FogCast-Konstanz/ceilometer/hardware/electronics/reference/schematic-sha256.txt

83A27CFF9CCC6BE23C81D1708697FAA548CE0A3112B7D12E5FBB0050944EA863  Ceilometer-Mainboard.kicad_sch
0DF4EA8A41C4C5A6A929BEEB0BAB2103AD3FB7023E3A1A09CEC28DEFCB5AE34C  laser_driver.kicad_sch
12897942866261051DC9896E344FCBBC590DF9CC13C2032FE289D9E452CD453B  microcontroller.kicad_sch
8D15DE4209DCBBF5A44544B6AAAC94CDBBDB7EB8A6270C29A0F63D7743F17740  power_supply.kicad_sch
557C2D40E5CBB65F0A0C12A197022C88FBC375FD6ED61630CAFE38675ACFBD1C  receiver.kicad_sch
54453B8D317E1929B59241BFBC5D7CDE180F8A41AEED6D8E985A71D2652C589C  TEC_driver.kicad_sch
