FogCast-Konstanz/ceilometer/docs/safety/Laser Safety calculation for 940 nm LIDAR.pdf

## Laser Safety calculation for 940 nm LIDAR

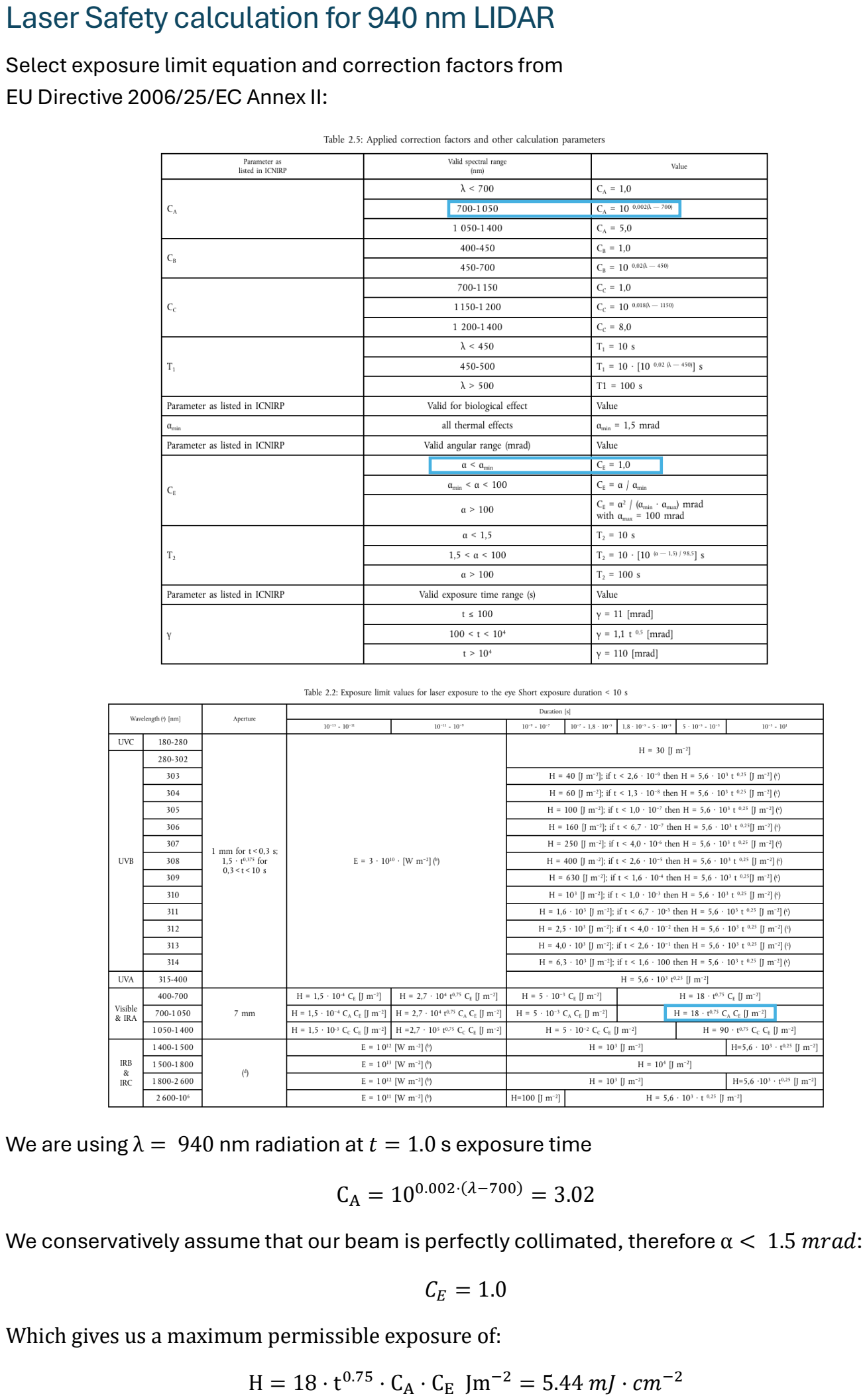
[picture p2: page 1]

Select exposure limit equation and correction factors from EU Directive 2006/25/EC Annex II:

We are using λ = 940 nm radiation at tt = 1.0 s exposure time

# CA = 100.002⋅(λλ−700) = 3.02

We conservatively assume that our beam is perfectly collimated, therefore α < 1.5 mmmmmmmm:

# CCEE = 1.0 Which gives us a maximum permissible exposure of: H = 18 ⋅ t0.75 ⋅ CA ⋅ CE Jm−2 = 5.44 mmmm · cc −2
