FogCast-Konstanz/ceilometer/hardware/mechanical/analysis/telescope/Mirror Cell Lever Load Study 1.html

Bildbreite (Pixel):

# Mirror Cell Lever Load Study

Analysierte Datei | Mirror Cell v4
Version | Autodesk Fusion (2605.1.52)
Erstellungsdatum | 2025-12-17, 17:04:57
Autor | Marian Keller

#### Berichtseigenschaften

Titel | Studien
Autor | Marian Keller

## Simulationsmodell 1

### Studie 1 - Nichtlineare statische Spannung

##### Eigenschaften der Studie

Studientyp | Nichtlineare statische Spannung
Letztes Änderungsdatum | 2025-12-17, 01:48:38

#### Einstellungen

##### Allgemein

Kontakttoleranz | 0.10 mm
Modi für starren Körper entfernen | Nein

##### Netz

Durchschnittl. Elementgröße (% der Modellgröße)
Volumenkörper | 10
Netzgröße pro Bauteil skalieren | Nein
Durchschnittliche Elementgröße (absoluter Wert) | -
Elementordnung | Parabolisch
Bogenförmige Netzelemente erstellen | Ja
Max. Drehwinkel auf Kurven (Grad) | 60
Max. Größenverhältnis benachbarter Netze | 1.5
Max. Seitenverhältnis | 10
Minimale Elementgröße (% der durchschnittlichen Größe) | 20

##### Verfeinerung adaptiver Netze

Anzahl der Verfeinerungsschritte | 0
Konvergenztoleranz für Ergebnisse (%) | 20

#### Materialien

Komponente | Material | Sicherheitsfaktor
Körper4 | Nylon 12 (mit 3D-Drucker Formlabs Fuse 1) | Streckgrenze

##### Nylon 12 (mit 3D-Drucker Formlabs Fuse 1)

Dichte | 1.015E-06 kg / mm^3
Elastizitätsmodul | 1850.00 MPa
Querdehnung | 0.35
Streckgrenze | 46.00 MPa
Zugfestigkeit | 50.00 MPa
Wärmeleitfähigkeit | 3.500E-04 W / (mm C)
Thermischer Ausdehnungskoeffizient | 1.275E-04 / C
Spezifische Wärme | 1830.00 J / (kg C)

#### Kontakte

#### Netz

Typ | Knoten | Elemente
Volumenkörper | 22067 | 12847

#### Lastfall1

#### Abhängigkeiten

##### Fest1

Typ | Fest
Ux | Fest
Uy | Fest
Uz | Fest

###### Ausgewählte Objekte

Verwenden Sie für die korrekte Interpretation dieses Bilds z. B. Internet Explorer 9, Chrome, Safari, Firefox.

#### Lasten

##### Kraft1

Typ | Kraft
Größe | 20.00 N
X-Wert | 0.00 N
Y-Wert | -20.00 N
Z-Wert | 0.00 N
Kraft pro Objekt | Nein

###### Ausgewählte Objekte

Verwenden Sie für die korrekte Interpretation dieses Bilds z. B. Internet Explorer 9, Chrome, Safari, Firefox.

#### Ergebnisse

##### Sicherheitsfaktor

##### Sicherheitsfaktor (pro Körper)

###### Schritt 10

0.00 8.00

Verwenden Sie für die korrekte Interpretation dieses Bilds z. B. Internet Explorer 9, Chrome, Safari, Firefox.

##### Spannung

##### von Mises

###### Schritt 10

[MPa] 0.00 4.689

Verwenden Sie für die korrekte Interpretation dieses Bilds z. B. Internet Explorer 9, Chrome, Safari, Firefox.

##### 1. Hauptspannung

###### Schritt 10

[MPa] -0.361 5.89

Verwenden Sie für die korrekte Interpretation dieses Bilds z. B. Internet Explorer 9, Chrome, Safari, Firefox.

##### 3. Hauptspannung

###### Schritt 10

[MPa] -3.531 0.989

Verwenden Sie für die korrekte Interpretation dieses Bilds z. B. Internet Explorer 9, Chrome, Safari, Firefox.

##### Verschiebung

##### Gesamt

###### Schritt 10

[mm] 0.00 0.235

Verwenden Sie für die korrekte Interpretation dieses Bilds z. B. Internet Explorer 9, Chrome, Safari, Firefox.

Bildbreite (Pixel):
