FogCast-Konstanz/ceilometer/hardware/electronics/mainboard/Ceilometer-Mainboard.csv

Reference | Qty | Value | DNP | Exclude from BOM | Exclude from Board | Footprint | MPN | Manufacturer
A1 | 1 | RaspberryPi Pico 2 |  |  |  | Module:RaspberryPi_Pico_Common_SMD | RP2350-Plus
C1,C2,C3,C13,C14,C15,C27,C28,C29,C30,C31,C55 | 12 | 47u |  |  |  | Capacitor_SMD:C_0805_2012Metric | LMK212BBJ476MG-T | Taiyo Yuden
C4,C5,C6,C9,C16,C21,C25,C26,C32,C33,C34,C35,C36,C37,C39,C40,C41,C42,C43,C44,C45,C46,C56,C57,C58,C60,C63,C66 | 28 | 1u |  |  |  | Capacitor_SMD:C_0402_1005Metric | C1005X5R1V105K050BE | TDK
C7,C8,C10,C11,C12,C17,C18,C22,C23,C24,C51,C54,C59,C64,C65 | 15 | 8.2n |  |  |  | Capacitor_SMD:C_0402_1005Metric | GRM1555C1H822JE01D | Murata
C19,C20,C38,C47,C48,C49,C50 | 7 | 220n |  |  |  | Capacitor_SMD:C_0402_1005Metric | GRM155R61J224ME01J | Murata
C52,C53 | 2 | 100p |  |  |  | Capacitor_SMD:C_0402_1005Metric | RF15N101J500CT | Walsin
C61,C62 | 2 | 100p |  |  |  | Capacitor_SMD:C_0201_0603Metric | CC0201JPNPO8BN101 | YAGEO
C67,C68 | 2 | 10u |  |  |  | Capacitor_SMD:C_0805_2012Metric |  | Murata
D1 | 1 | ESD321DYAR |  |  |  | Diode_SMD:D_SOD-523 | ESD321DYAR | TI
D2 | 1 | AFBR-S4P11P012R |  |  |  | SiPM_usr:Broadcom_AFBR-S4P11P012R | AFBR-S4P11P012R | Broadcom
F1 | 1 | 7A |  |  |  | Fuse:Fuseholder_Littelfuse_Nano2_154x | 0154007.DRT | Littlefuse
FB1,FB2 | 2 | 1.8k |  |  |  | Inductor_SMD:L_0402_1005Metric | MMZ1005A182ET000 | TDK
IC1 | 1 | LT8722AV#PBF |  |  |  | Analog_Devices_usr:LT8722AVPBF | LT8722AV#PBF | Analog Devices
J1 | 1 | 5V IN |  |  |  | TerminalBlock_RND:TerminalBlock_RND_205-00001_1x02_P5.00mm_Horizontal
J2 | 1 | TEC_OUT |  |  |  | Connector_Molex:Molex_Pico-EZmate_78171-0002_1x02-1MP_P1.20mm_Vertical
J3 | 1 | Conn_02x06_Odd_Even |  |  |  | Connector_PinHeader_2.54mm:PinHeader_2x06_P2.54mm_Vertical
J4,J5 | 2 | USB_C_Receptacle |  |  |  | Connector_USB:USB_C_Receptacle_Amphenol_12401610E4-2A | 12401610E4#2A | Amphenol
L1 | 1 | 22u |  |  |  | Inductor_SMD:L_Abracon_ASPI-4030S | ASPI-4030S-220M-T | Abracon
L2 | 1 | 1u |  |  |  | Inductor_SMD_Wurth:L_Wurth_WE-PMFI-252012 | 74479325207210 | Würth
L3 | 1 | 15u |  |  |  | Industor_usr:PFL4514 | PFL4514-153MEC | Coilcraft
LD1 | 1 | Laser Diode 940 nm |  |  |  | Connector_Molex:Molex_Pico-EZmate_78171-0002_1x02-1MP_P1.20mm_Vertical | 781710002 | Molex
R1 | 1 | 120 |  |  |  | Resistor_SMD:R_0402_1005Metric | ERA-2AEB121X | Panasonic
R2 | 1 | 200 |  |  |  | Resistor_SMD:R_0402_1005Metric | ERA-2AED201X | Panasonic
R3,R4,R5,R7,R11,R18,R19,R20,R33,R34,R35,R36 | 12 | 4k7 |  |  |  | Resistor_SMD:R_0402_1005Metric | ERA-2AED472X | Panasonic
R6,R13,R24,R25,R26,R27 | 6 | 1 |  |  |  | Resistor_SMD:R_0402_1005Metric | CRCW04021R00FKED | Vishay
R8,R10,R23,R28 | 4 | 10k |  |  |  | Resistor_SMD:R_0402_1005Metric | ERA-2AEB103X | Panasonic
R9 | 1 | 40m |  |  |  | Resistor_SMD:R_0603_1608Metric | PE0603DRF570R04L | YAGEO
R12 | 1 | 60.4 |  |  |  | Resistor_SMD:R_0402_1005Metric | RG1005P-60R4-D-T10 | Susumu
R14,R17 | 2 | 604k |  |  |  | Resistor_SMD:R_0402_1005Metric | CR0402-FX-6043GLF | Bourns
R15 | 1 | 4.99k |  |  |  | Resistor_SMD:R_0402_1005Metric | RT0402BRD074K99L | YAGEO
R16 | 1 | 33.2k |  |  |  | Resistor_SMD:R_0402_1005Metric | RT0402BRD0733K2L | YAGEO
R21 | 1 | 20k |  |  |  | Resistor_SMD:R_0402_1005Metric | ERA-2AED203X | Panasonic
R22 | 1 | 15.4k |  |  |  | Resistor_SMD:R_0402_1005Metric | RT0402BRD0715K4L | YAGEO
R29,R30 | 2 | 50 |  |  |  | Resistor_SMD:R_0402_1005Metric | TNPW040250R0BEED | Vishay
R31,R32 | 2 | 50 |  |  |  | Resistor_SMD:R_0201_0603Metric | TNPW020150R0DEED | Vishay
U1 | 1 | AZ1084 |  |  |  | Package_TO_SOT_SMD:TO-263-2 | AZ1084CD-ADJTRG1 | Diodes
U2,U6,U16 | 3 | AD5693R |  |  |  | Package_SO:MSOP-10_3x3mm_P0.5mm | AD5693RARMZ-RL7 | Analog Devices
U3 | 1 | iC-HG30 |  |  |  | Driver_Laser:QFN-28-1EP_5x5mm_P0.5mm_EP3.1x3.15mm_ThermalVias | iC-HG30 | ic-haus
U4 | 1 | INA293B1 |  |  |  | Package_TO_SOT_SMD:SOT-23-5 | INA293B1IDBVR | TI
U5 | 1 | LT3571 |  |  |  | LT3571:QFN-16-1EP_3x3mm_P0.5mm_EP1.45x1.45mm_ThermalVias | LT3571EUD#PBF | Analog Devices
U7,U9,U12 | 3 | NCV8161AMX330 |  |  |  | Package_SON_usr:Texas_XDFN-4_1x1mm_P0.65mm | NCV8161AMX330TBG | onsemi
U8 | 1 | TVS0500DRV |  |  |  | Package_SON:WSON-6-1EP_2x2mm_P0.65mm_EP1x1.6mm | TVS0500DRV | Texas Instruments
U10 | 1 | SN65LVDT2DBV |  |  |  | Package_TO_SOT_SMD:SOT-23-5 | SN65LVDT2DBV | TI
U11 | 1 | REF3030 |  |  |  | Package_TO_SOT_SMD:SOT-23 | REF3030AIDBZT | TI
U13 | 1 | NCV8161AMX180 |  |  |  | Package_SON_usr:Texas_XDFN-4_1x1mm_P0.65mm | NCV8161AMX330TBG | onsemi
U14 | 1 | QPL7442 |  |  |  | Package_DFN_QFN:DFN-8-1EP_2x2mm_P0.5mm_EP0.8x1.6mm | QPL7442 | Qorvo
U15 | 1 | TLV3801 |  |  |  | Comparator_usr:TLV3801DSGR | TLV3801DSGR | Texas Instruments
U17 | 1 | MCP9800A |  |  |  | Package_TO_SOT_SMD:SOT-23-5 | MCP9800A0T-M/OT | Microchip
U18 | 1 | DS18B20 |  |  |  | Connector_PinHeader_2.54mm:PinHeader_1x03_P2.54mm_Vertical | DS18B20 | Analog Devices
