FogCast-Konstanz/ceilometer/hardware/electronics/mainboard/Ceilometer-Mainboard-B2-Edge_Cuts.dxf

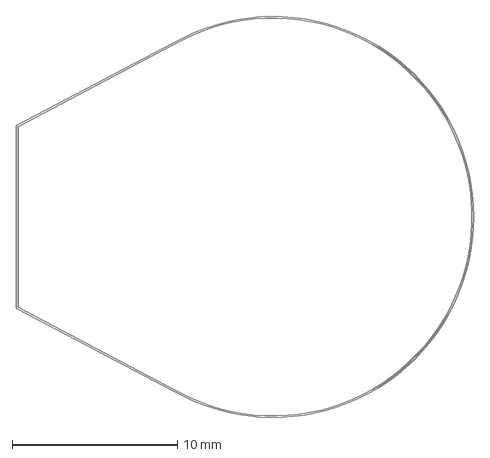
[picture p3: CAD file, 2026-11-01]
hardware/electronics/mainboard/Ceilometer-Mainboard-B2-Edge_Cuts.dxf
27.7 x 24.3 mm
