FogCast-Konstanz/ceilometer/hardware/electronics/mainboard/3D/ti/TLV3801DSGR.stp

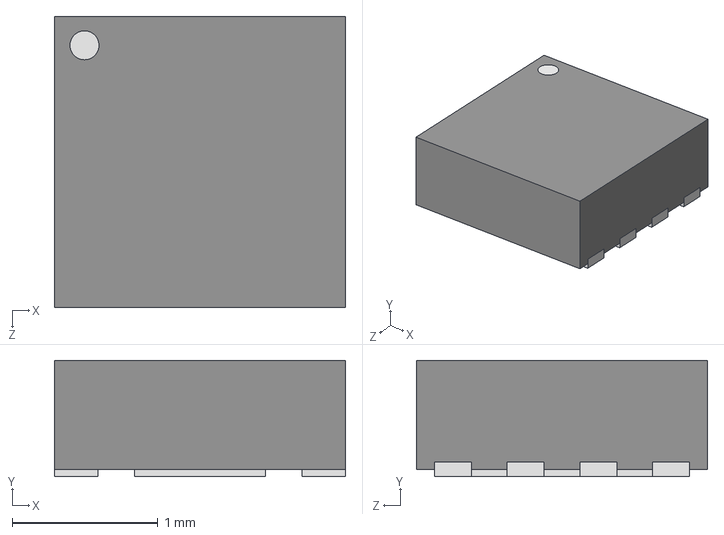
[picture p4: CAD file, 2026-11-01]
hardware/electronics/mainboard/3D/ti/TLV3801DSGR.stp
2.00 x 0.8 x 2.00 mm
