FogCast-Konstanz/ceilometer/hardware/mechanical/cad/exchange/Ceilometer-Optikplatte.dxf

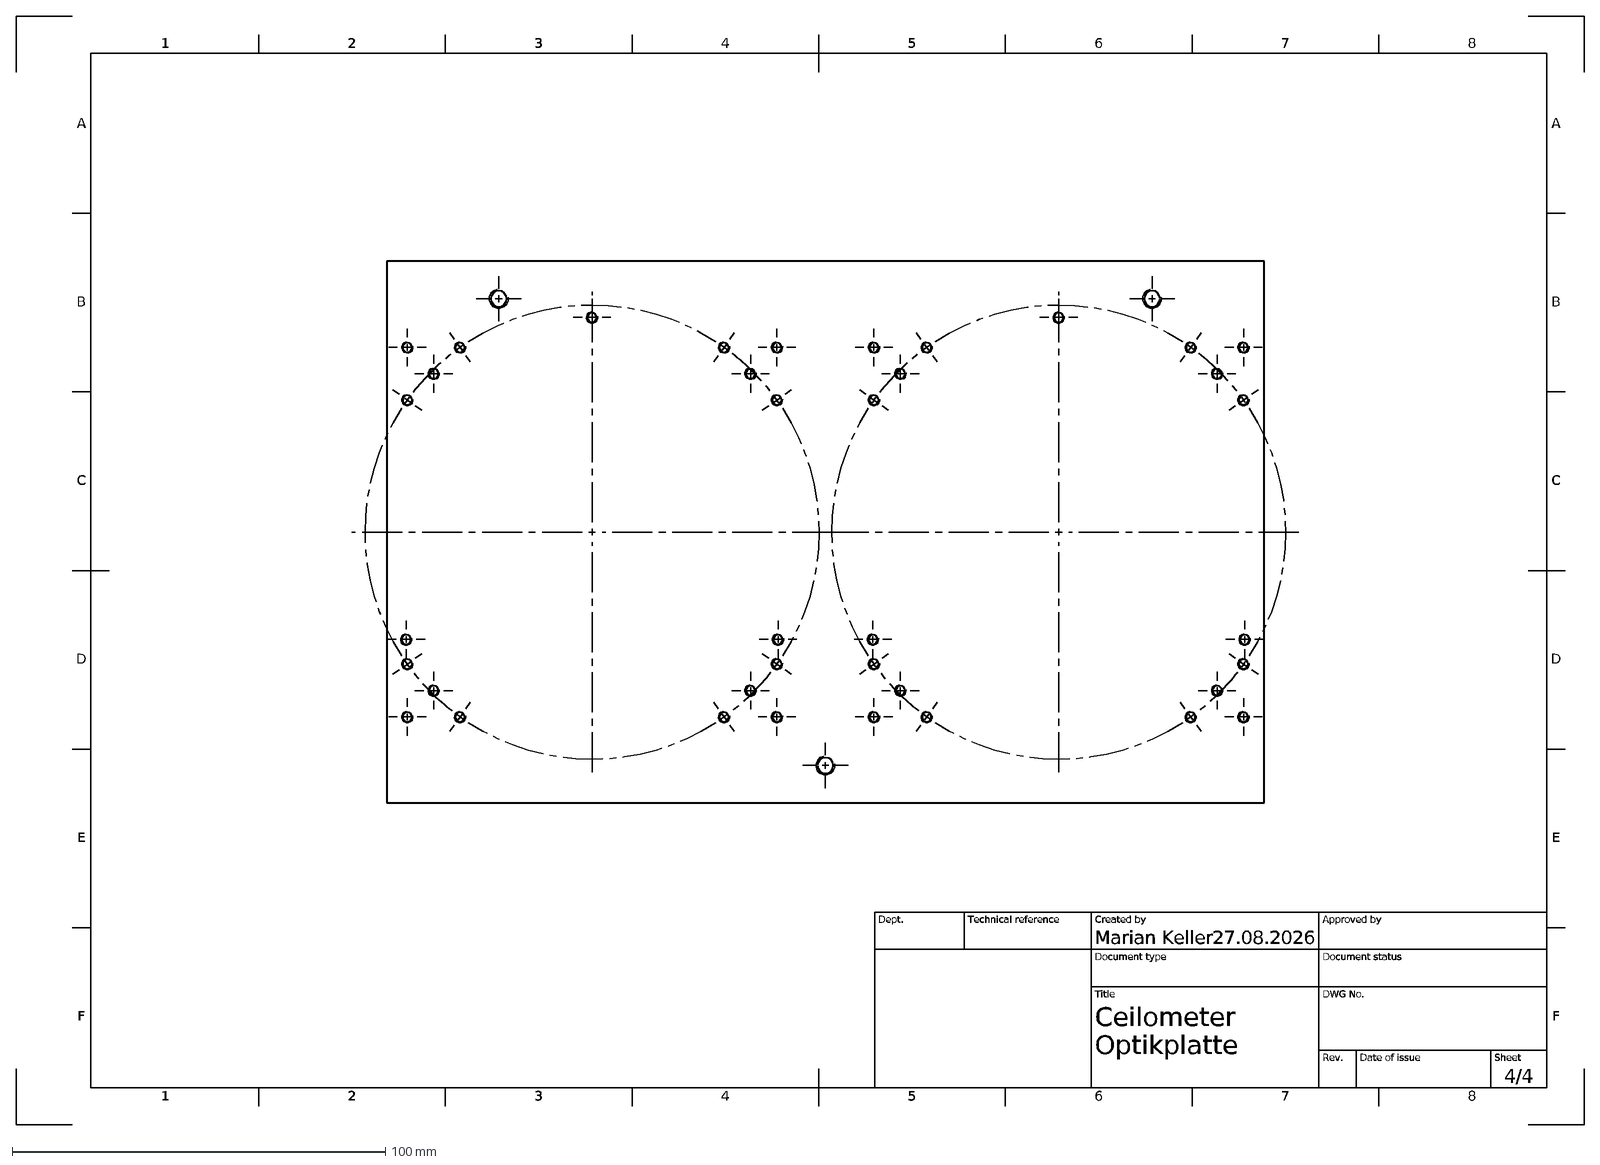
[picture p5: CAD file, 2026-11-01]
hardware/mechanical/cad/exchange/Ceilometer-Optikplatte.dxf
27.08.2026
4/4
Optikplatte
Ceilometer
Marian Keller
Dept.
Technical reference
Created by
Approved by
Document type
Document status
Title
DWG No.
Rev.
Date of issue
Sheet
1
A
2
3
4
5
6
7
8
B
C
D
E
F
