FogCast-Konstanz/ceilometer/(list of files, cad)

Other CAD files:
hardware/electronics/mainboard/Ceilometer-Mainboard-B.step
hardware/mechanical/cad/exchange/Ceilometer-Rahmen v9.step
hardware/mechanical/cad/meshes/Laser-Clamp.stl
hardware/mechanical/printing/Strebenhalter.3mf
hardware/mechanical/cad/meshes/Strebenhalter.stl
hardware/mechanical/printing/Spiegelhalteblock.3mf
hardware/mechanical/cad/meshes/Rohrzentrierer.stl
hardware/mechanical/printing/Endhalter_plate_2.gcode.3mf
hardware/mechanical/cad/meshes/Transmitter-Mount.stl
hardware/mechanical/printing/Strebenhalter.gcode.3mf
hardware/mechanical/cad/meshes/Receiver-Mount.stl
hardware/mechanical/printing/Endhalter.gcode.3mf
hardware/mechanical/cad/meshes/Spiegelhalteblock.stl
hardware/mechanical/printing/Endhalter.3mf
hardware/mechanical/cad/meshes/Endhalter.stl
hardware/mechanical/cad/meshes/Spannring.stl
