FogCast-Konstanz/ceilometer/docs/mainboard-overclock-results.txt

$ACK,get_clock,500000000,500000,18
$ACK,i2c_scan,0,1,1,1,1,0,110,2,76,78
$ACK,i2c_scan,1,1,1,1,1,0,110,2,72,78
$ACK,get_telemetry,dac0_readback,code,0,1,24835171,50019,249
$ACK,get_telemetry,dac1_readback,code,0,1,24835474,50358,249
$ACK,get_telemetry,dac2_readback,code,0,1,24835777,50843,249
$ACK,get_telemetry,lt_register0,bits,565780,1,24835853,51450,249
$ACK,get_clock,500000000,500000,18
$ACK,sensors,64,697,0,1,23125,1,45312
$ACK,get_telemetry,mcu_temperature_mc,mC,61865,1,24832344,63314,249
$ACK,get_telemetry,lt_register0,bits,565780,1,24835853,60466,249
$ACK,get_state,IDLE,0,0,0,0,0,0,0
$ACK,get_clock,500000000,500000,18
$ACK,sensors,66,694,0,1,23125,1,45312
$ACK,get_telemetry,mcu_temperature_mc,mC,61865,1,25332345,70284,254
$ACK,get_telemetry,lt_register0,bits,565780,1,25335854,67271,254
$ACK,get_state,IDLE,0,0,0,0,0,0,0
$ACK,get_clock,500000000,500000,18
$ACK,sensors,67,688,0,1,23125,1,45250
$ACK,get_telemetry,mcu_temperature_mc,mC,61865,1,25832345,82222,259
$ACK,get_telemetry,lt_register0,bits,565780,1,25835854,79400,259
$ACK,get_state,IDLE,0,0,0,0,0,0,0
$ACK,get_clock,500000000,500000,18
$ACK,sensors,66,688,0,1,23125,1,45312
$ACK,get_telemetry,mcu_temperature_mc,mC,61865,1,26332345,90967,264
$ACK,get_telemetry,lt_register0,bits,565780,1,26335854,88124,264
$ACK,get_state,IDLE,0,0,0,0,0,0,0
$ACK,get_clock,500000000,500000,18
$ACK,sensors,64,685,0,1,23125,1,45312
$ACK,get_telemetry,mcu_temperature_mc,mC,61865,1,26932346,4101,270
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
$ACK,get_state,IDLE,0,0,0,0,0,0,0
$ACK,get_clock,500000000,500000,18
$ACK,sensors,66,692,0,1,23187,1,46750
$ACK,get_telemetry,mcu_temperature_mc,mC,62717,1,70332503,55850,704
$ACK,get_telemetry,lt_register0,bits,565780,1,70336013,52953,704
$ACK,get_state,IDLE,0,0,0,0,0,0,0
