FogCast-Konstanz/ceilometer/software/bringup/index.html

⌁

# Ceilometer board console

DisconnectedTry demoConnect USBDisconnect■ Stop all

SIMULATED BOARD · No hardware connection Inject fault

Web Serial is unavailable. Open this page in desktop Chrome or Edge. Demo mode remains available.

Connect the Pico 2 USB port to inspect the board, or explore demo mode.

No board connectedOFFLINEOutputs —Storage —

Laser temperature—

Receiver temperature—

TEC differential output—

SiPM count rate—

SiPM bias target—

## Transmitter

### TEC regulation

OFF

Waiting for temperature feedback

Enable PIDDisable TEC

Set target, PID gains and commissioned polarity in Parameters.

### Laser driver

DISARMED

Arm laserDisarm / stop outputs

Laser DAC code ceiling —Apply laser DAC

Firmware enforces the temperature window, fault latch and build ceiling.

## Receiver

### SiPM bias

OFF

Waiting for receiver feedback

Enable biasDisable bias

Test temperature (°C) Enable bias without receiver (test)

### Discriminator

Counter (16-bit, wraps)—

Receiver threshold / mV

Apply threshold

Save in Parameters to persist

## Board diagnostics

Read feedback first, then exercise each functional block.

GP12 test pulse / Hz

Apply pulsePulse off

Scan receiver I²CScan main I²C

I²C scan requires all outputs off

Clear faultRefresh inventory

Loopback requires a verified GP12 → GP5 bench connection. Clearing a fault never restarts outputs.

LIVE INSTRUMENTATION

## Temperature traces

Pause plotClear

10−1

°C

−30 snow

Connect to begin polling
Invalid feedback leaves gaps in the trace

Export telemetry CSV

Plot channel Add traceUp to 4 channels with matching units

05

## Digital acquisition

1023 BINS

Dark capture keeps the laser gate low and emits diagnostic PRN on GP13.

FramesDark captureEmitting captureRead board resultExport capture CSV

Start repeated darkStart repeated laserRead integrated result

## Peripheral health

Not polling

## All board telemetry

Values are exact firmware integers. Age includes time since the browser received the sample. The table marks stale links and failed device reads.

Signal | Value | Unit | Validity | Age / ms | Sequence | Trace

## Persistent configuration

Export JSON

Stage up to eight changes and apply them atomically. All outputs and acquisition must be off. Save explicitly to persist; enable/arm states are never stored.

Apply staged 0Save to flashLoad savedRAM defaultsDiscard edits

Parameter | Current | Staged value | Unit | Bounds | Default

## USB command log

Export logClear log

CommandSend

Exact ASCII protocol, one request at a time. Sending configuration or output commands here still uses firmware interlocks. A timeout closes the session to avoid accepting a late ACK.
