FogCast-Konstanz/ceilometer/docs/production-overclock-results.txt

$ACK,stop
$ACK,get_clock,500000000,500000,18
$ACK,get_param,bias_gain_ppm,989241,ppm_of_nominal,800000,1200000,1000000
$ACK,get_param,bias_offset_uv,-4925156,uV,-6000000,-4000000,-5000000
$ACK,capture
$ACK,get_state,READY,16,0,1638,0,0,0,44009
$ACK,capture
$ACK,get_state,READY,16,0,1637,0,0,0,44009
$ACK,capture
$ACK,get_state,READY,16,0,1638,0,0,0,44008
$ACK,capture
$ACK,get_state,READY,16,0,1638,0,0,0,44009
$ACK,capture
$ACK,get_state,READY,16,0,1638,0,0,0,44009
$ACK,capture
$ACK,get_state,READY,16,0,1638,0,0,0,44009
$ACK,capture
$ACK,get_state,READY,16,0,1638,0,0,0,44009
$ACK,capture
$ACK,get_state,READY,16,0,1638,0,0,0,44008
$ACK,capture
$ACK,get_state,READY,16,0,1637,0,0,0,44009
$ACK,capture
$ACK,get_state,READY,16,0,1637,0,0,0,44009
$ACK,capture
$ACK,get_state,READY,16,0,1638,0,0,0,44008
$ACK,capture
$ACK,get_state,READY,16,0,1637,0,0,0,44009
$ACK,capture
$ACK,get_state,READY,16,0,1637,0,0,0,44009
$ACK,capture
$ACK,get_state,READY,16,0,1638,0,0,0,44008
$ACK,capture
$ACK,get_state,READY,16,0,1638,0,0,0,44008
$ACK,capture
$ACK,get_state,READY,16,0,1638,0,0,0,44008
$ACK,capture
$ACK,get_state,READY,16,0,1637,0,0,0,44009
$ACK,capture
$ACK,get_state,READY,16,0,1638,0,0,0,44009
$ACK,capture
$ACK,get_state,READY,16,0,1638,0,0,0,44008
$ACK,capture
$ACK,get_state,READY,16,0,1638,0,0,0,44009
$ACK,sensors,63,673,0,1,23375,1,52937
$ACK,get_storage,1,0,23,22,0,2
$ACK,stop
