FogCast-Konstanz/ceilometer/analysis/bench-tests/legacy/bias-off-idle-repeat.csv

threshold_mv | threshold_code | counts | duration_us | rate_cps | max_poll_gap_us | prn_enabled | bias_enabled
1795 | 47055 | 0 | 1000000 | 0.000 | 2 | 0 | 0
1800 | 47186 | 0 | 1000000 | 0.000 | 2 | 0 | 0
1804 | 47291 | 0 | 1000000 | 0.000 | 2 | 0 | 0
1805 | 47317 | 0 | 1000000 | 0.000 | 2 | 0 | 0
1806 | 47343 | 0 | 1000000 | 0.000 | 2 | 0 | 0
1806.5 | 47356 | 1289 | 1000000 | 1289.000 | 2 | 0 | 0
1807 | 47369 | 2684900 | 1000000 | 2684900.000 | 2 | 0 | 0
1807.5 | 47383 | 56973227 | 1000000 | 56973227.000 | 2 | 0 | 0
1808 | 47396 | 29732271 | 1000000 | 29732271.000 | 2 | 0 | 0
1808.5 | 47409 | 1004793 | 1000000 | 1004793.000 | 2 | 0 | 0
1809 | 47422 | 2010 | 1000000 | 2010.000 | 2 | 0 | 0
1810 | 47448 | 0 | 1000000 | 0.000 | 2 | 0 | 0
1815 | 47579 | 0 | 1000000 | 0.000 | 2 | 0 | 0
