FogCast-Konstanz/ceilometer/analysis/bench-tests/legacy/bias-series-1809p4.csv

mode | ov_mv | threshold_code | threshold_mv | counts | duration_us | rate_cps | first_second_counts | second_second_counts | max_poll_gap_us | temperature_start_mc | temperature_end_mc | target_start_uv | target_end_uv | estimated_end_uv | bias_code
off_before | 0 | 47432 | 1809.4 | 0 | 2000000 | 0.000 | 0 | 0 | 2 | 57000 | 56937 | 48740000 | 48735590 | 48734933 | 58824
on | 1000 | 47432 | 1809.4 | 0 | 2000000 | 0.000 | 0 | 0 | 2 | 56937 | 56937 | 39735590 | 39735590 | 39735027 | 48958
on | 2000 | 47432 | 1809.4 | 1 | 2000000 | 0.500 | 0 | 1 | 2 | 56937 | 57000 | 40735590 | 40740000 | 40739375 | 50059
on | 3000 | 47432 | 1809.4 | 0 | 2000000 | 0.000 | 0 | 0 | 2 | 57000 | 56937 | 41740000 | 41735590 | 41735513 | 51151
on | 4000 | 47432 | 1809.4 | 9 | 2000000 | 4.500 | 6 | 3 | 2 | 56937 | 56937 | 42735590 | 42735590 | 42735300 | 52247
on | 5000 | 47432 | 1809.4 | 88 | 2000000 | 44.000 | 37 | 51 | 2 | 56937 | 56937 | 43735590 | 43735590 | 43735087 | 53343
on | 6000 | 47432 | 1809.4 | 951 | 2000000 | 475.500 | 427 | 524 | 2 | 56937 | 56937 | 44735590 | 44735590 | 44734873 | 54439
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
