FogCast-Konstanz/ceilometer/analysis/bench-tests/legacy/dark-overvoltage-sweep.csv

ov_mv | threshold_mv | threshold_code | counts | integration_us | rate_cps | temperature_mc | target_uv | estimated_uv | bias_code
5000 | 1798 | 47133 | 0 | 16368 | 0.000 | 55625 | 43643750 | 43642953 | 53242
5000 | 1800 | 47186 | 0 | 16368 | 0.000 | 55625 | 43643750 | 43642953 | 53242
5000 | 1801 | 47212 | 0 | 16368 | 0.000 | 55625 | 43643750 | 43642953 | 53242
5000 | 1802 | 47238 | 0 | 16368 | 0.000 | 55625 | 43643750 | 43642953 | 53242
5000 | 1803 | 47265 | 0 | 16368 | 0.000 | 55625 | 43643750 | 43642953 | 53242
5000 | 1804 | 47291 | 10 | 16368 | 610.948 | 55625 | 43643750 | 43642953 | 53242
5000 | 1805 | 47317 | 1305 | 16368 | 79728.739 | 55625 | 43643750 | 43642953 | 53242
5000 | 1806 | 47343 | 38663 | 16368 | 2362108.993 | 55625 | 43643750 | 43642953 | 53242
5000 | 1807 | 47369 | 452088 | 16368 | 27620234.604 | 55625 | 43643750 | 43642953 | 53242
5000 | 1808 | 47396 | 576864 | 16368 | 35243401.760 | 55625 | 43643750 | 43642953 | 53242
5000 | 1809 | 47422 | 45 | 16368 | 2749.267 | 55625 | 43643750 | 43642953 | 53242
5000 | 1810 | 47448 | 0 | 16368 | 0.000 | 55625 | 43643750 | 43642953 | 53242
5000 | 1812 | 47500 | 0 | 16368 | 0.000 | 55687 | 43648090 | 43647514 | 53247
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
