FogCast-Konstanz/ceilometer/analysis/bench-tests/legacy/high-threshold-dark-sweep.csv

bias_enabled | threshold_mv | threshold_code | counts | duration_us | rate_cps | max_poll_gap_us | temperature_mc | target_uv
0 | 1809.1 | 47424 | 255 | 1000000 | 255.000 | 2 | 56812 | 48726840
0 | 1809.2 | 47427 | 126 | 1000000 | 126.000 | 2 | 56812 | 48726840
0 | 1809.4 | 47432 | 0 | 1000000 | 0.000 | 2 | 56750 | 48722500
0 | 1809.6 | 47438 | 0 | 1000000 | 0.000 | 2 | 56812 | 48726840
0 | 1809.8 | 47443 | 0 | 1000000 | 0.000 | 2 | 56812 | 48726840
0 | 1810 | 47448 | 0 | 1000000 | 0.000 | 2 | 56812 | 48726840
0 | 1810.2 | 47453 | 0 | 1000000 | 0.000 | 2 | 56812 | 48726840
0 | 1810.5 | 47461 | 0 | 1000000 | 0.000 | 2 | 56812 | 48726840
0 | 1811 | 47474 | 0 | 1000000 | 0.000 | 2 | 56875 | 48731250
0 | 1812 | 47500 | 0 | 1000000 | 0.000 | 2 | 56812 | 48726840
0 | 1815 | 47579 | 0 | 1000000 | 0.000 | 2 | 56812 | 48726840
0 | 1820 | 47710 | 0 | 1000000 | 0.000 | 2 | 56812 | 48726840
0 | 1850 | 48497 | 0 | 1000000 | 0.000 | 2 | 56812 | 48726840
1 | 1809.1 | 47424 | 986660 | 1000000 | 986660.000 | 2 | 56812 | 48726840
1 | 1809.2 | 47427 | 544339 | 1000000 | 544339.000 | 2 | 56750 | 48722500
1 | 1809.4 | 47432 | 222364 | 1000000 | 222364.000 | 2 | 56750 | 48722500
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
