FogCast-Konstanz/ceilometer/hardware/mechanical/analysis/mockup/Mockup Zeichnung v0.pdf

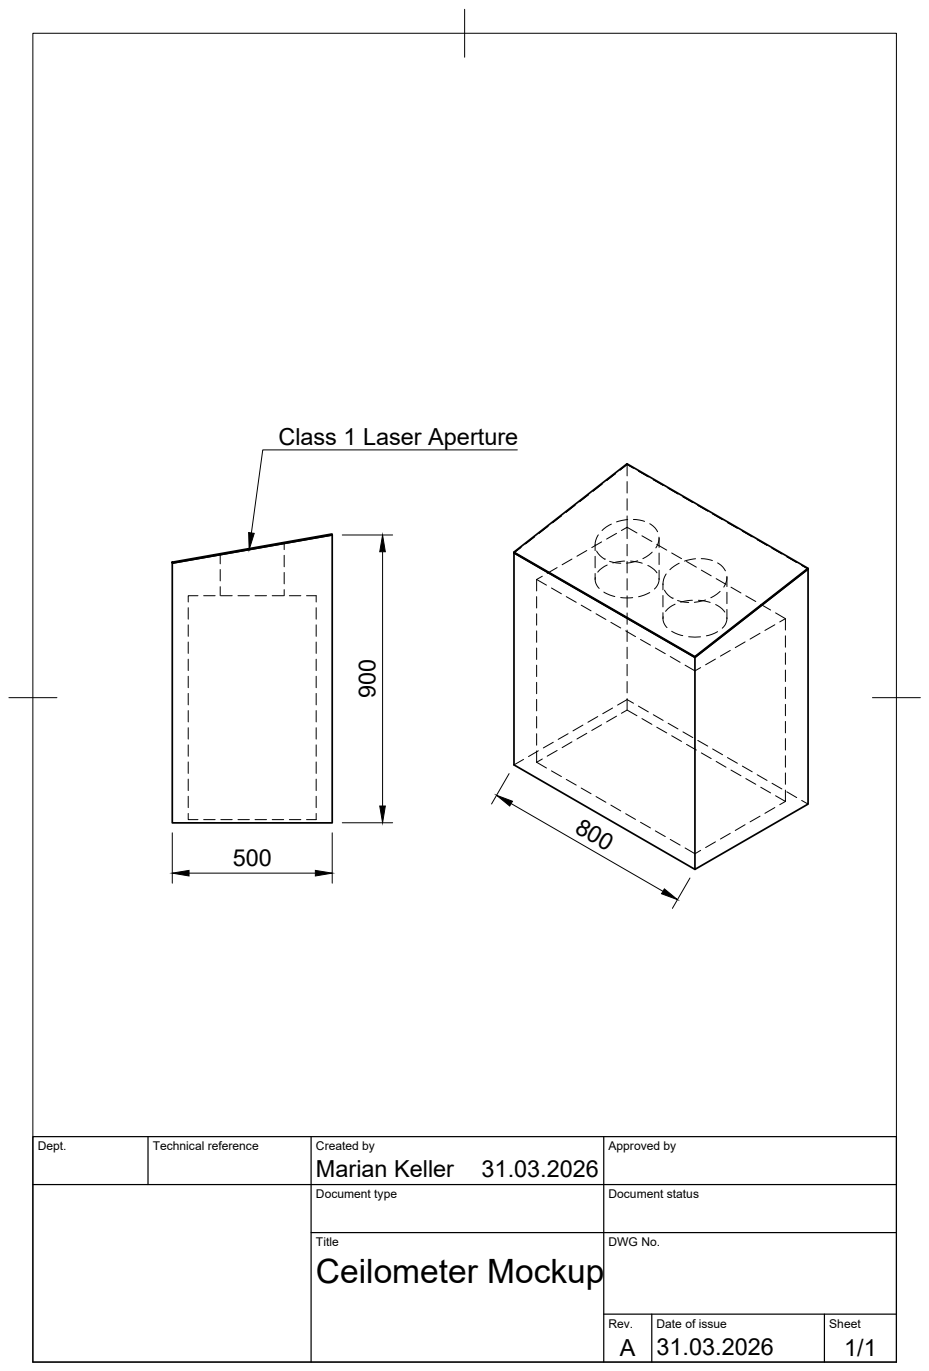
[picture p6: page 1]

Class 1 Laser Aperture
Marian Keller 900

Dept. | Technical reference | Created by 31.03.2026 | Approved by

Document type | Document status

Title Ceilometer Mockup | DWG No.

Rev. A | Date of issue 31.03.2026 | Sheet 1/1
