FogCast-Konstanz/ceilometer/hardware/electronics/simulations/LD_CS_Filter_Bode.pdf

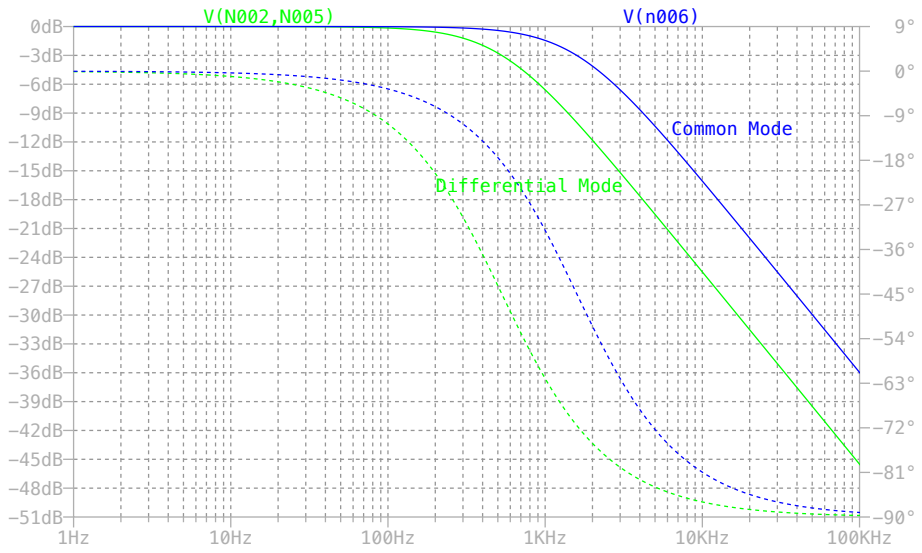
[picture p7: page 1]
