FogCast-Konstanz/ceilometer/hardware/electronics/simulations/LD_CS_Filter_Ripple.pdf

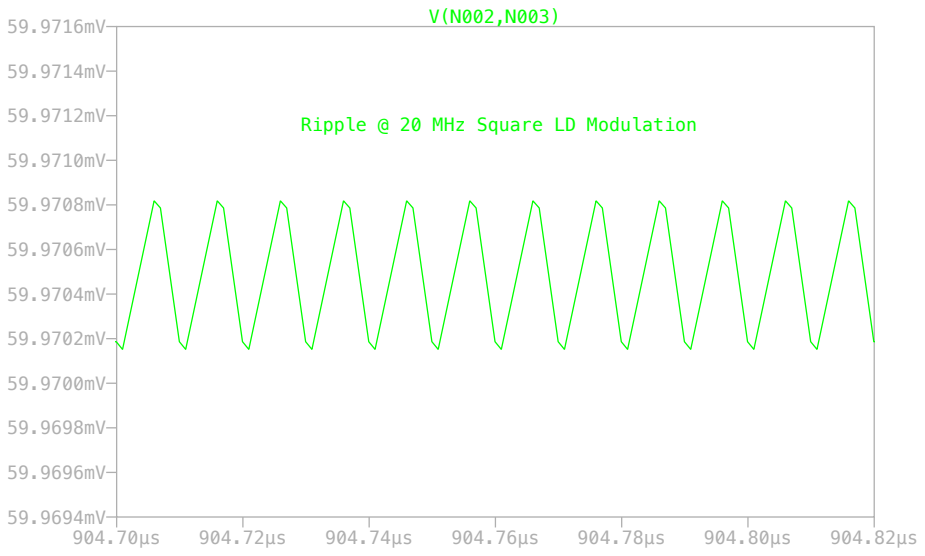
[picture p8: page 1]

Ripple @ 20 MHz Square LD Modulation
