FogCast-Konstanz/ceilometer/hardware/mechanical/drawings/Ceilometer-Rahmen Zeichnung v3.pdf

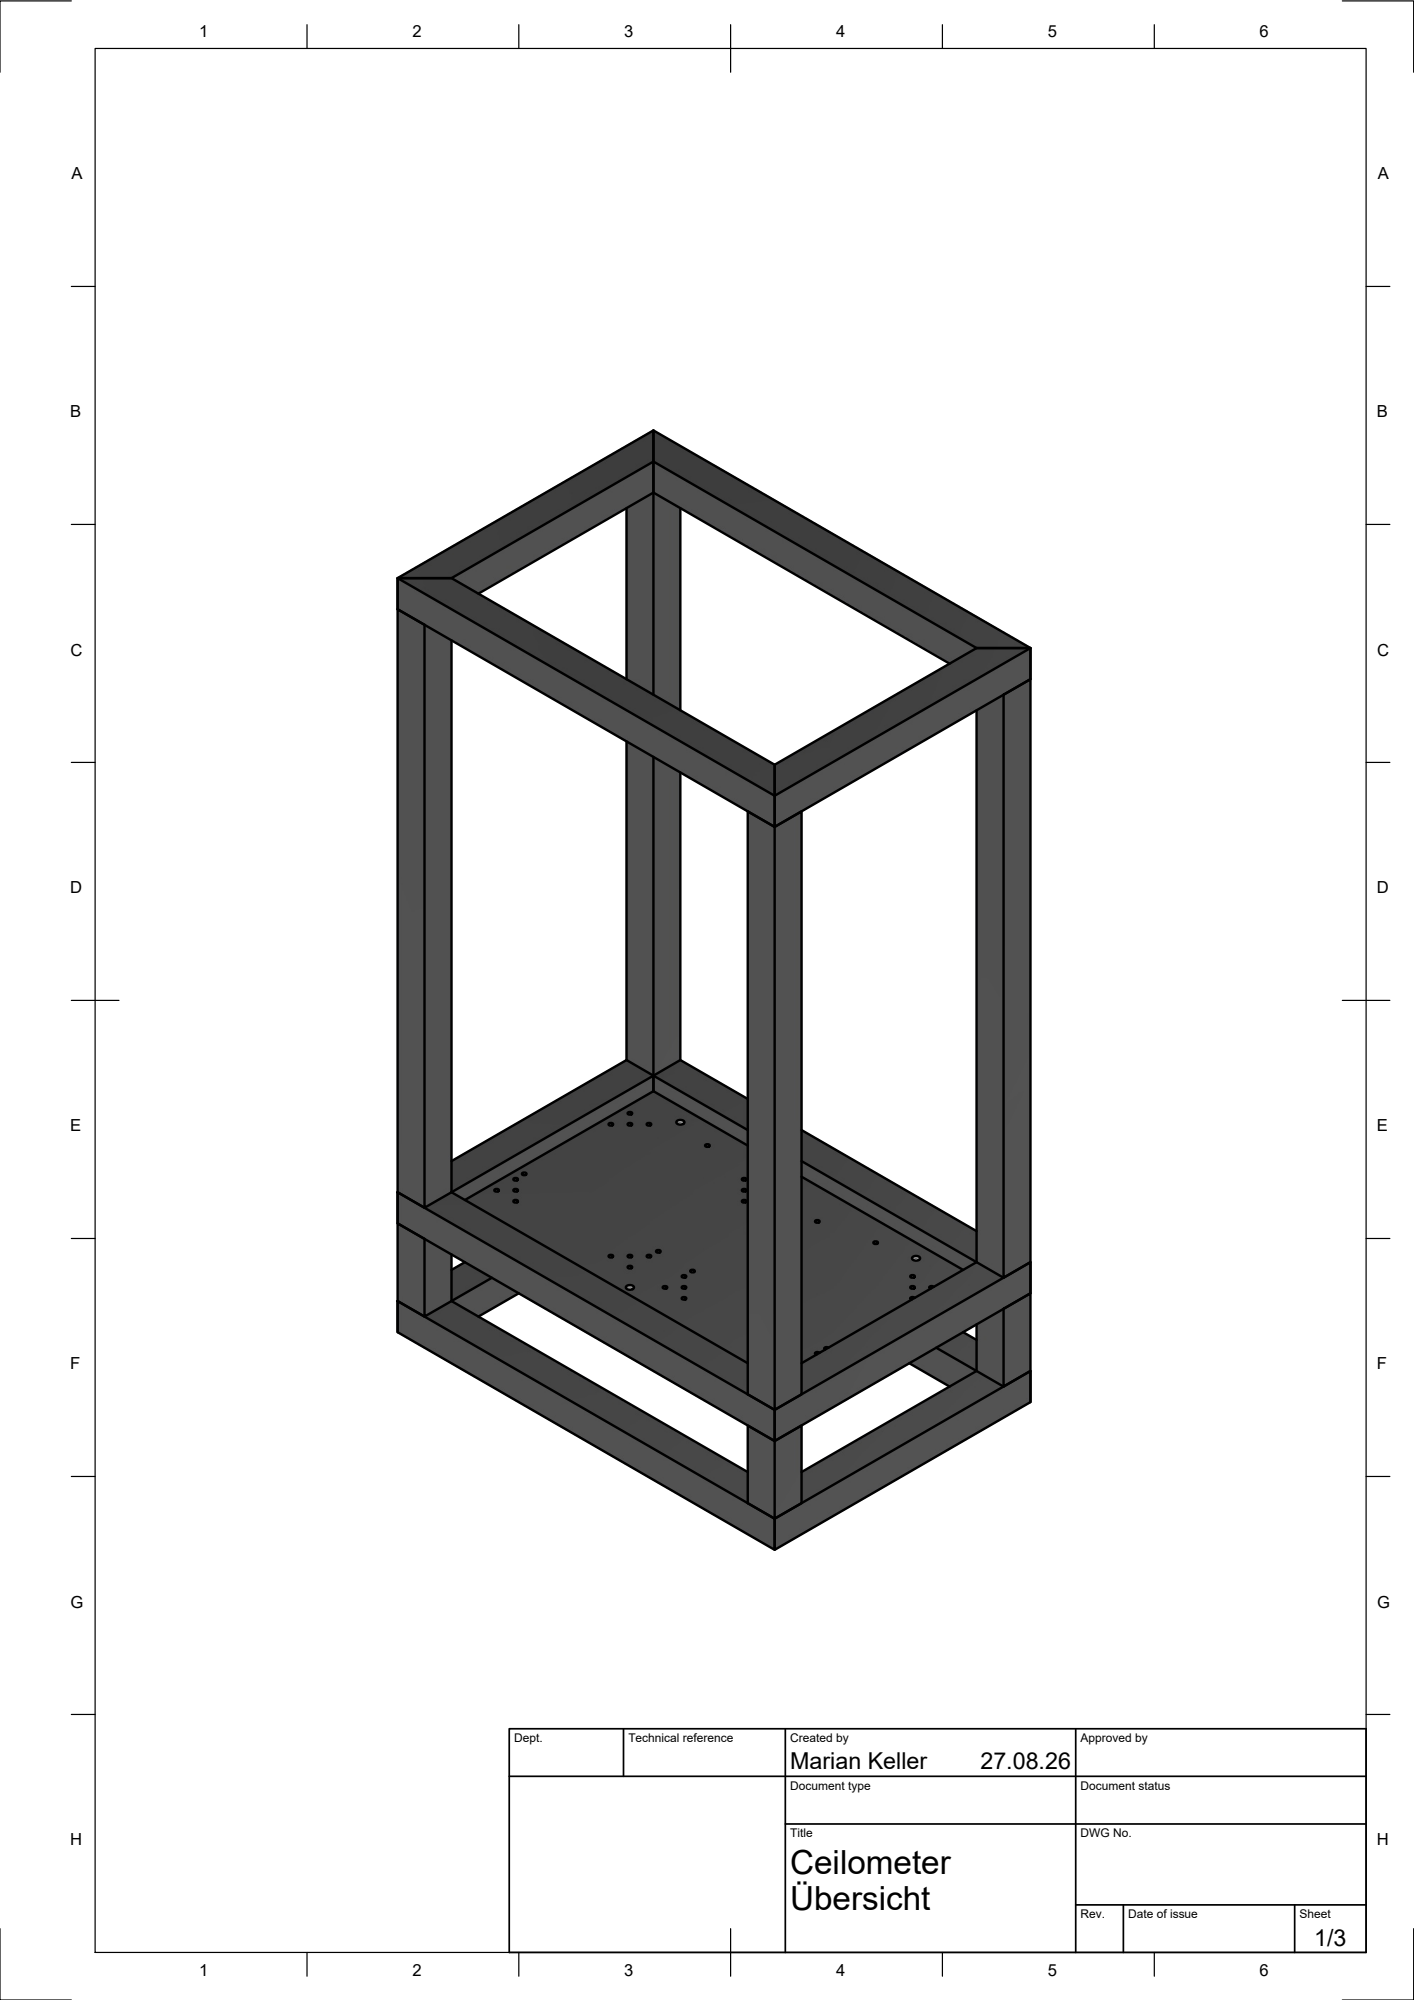
[picture p9: page 1]

Dept. | Technical reference | Created by Marian Keller 27.08.26 | Approved by

Document type | Document status

Title Ceilometer Übersicht | DWG No.

Rev. | Date of issue | Sheet

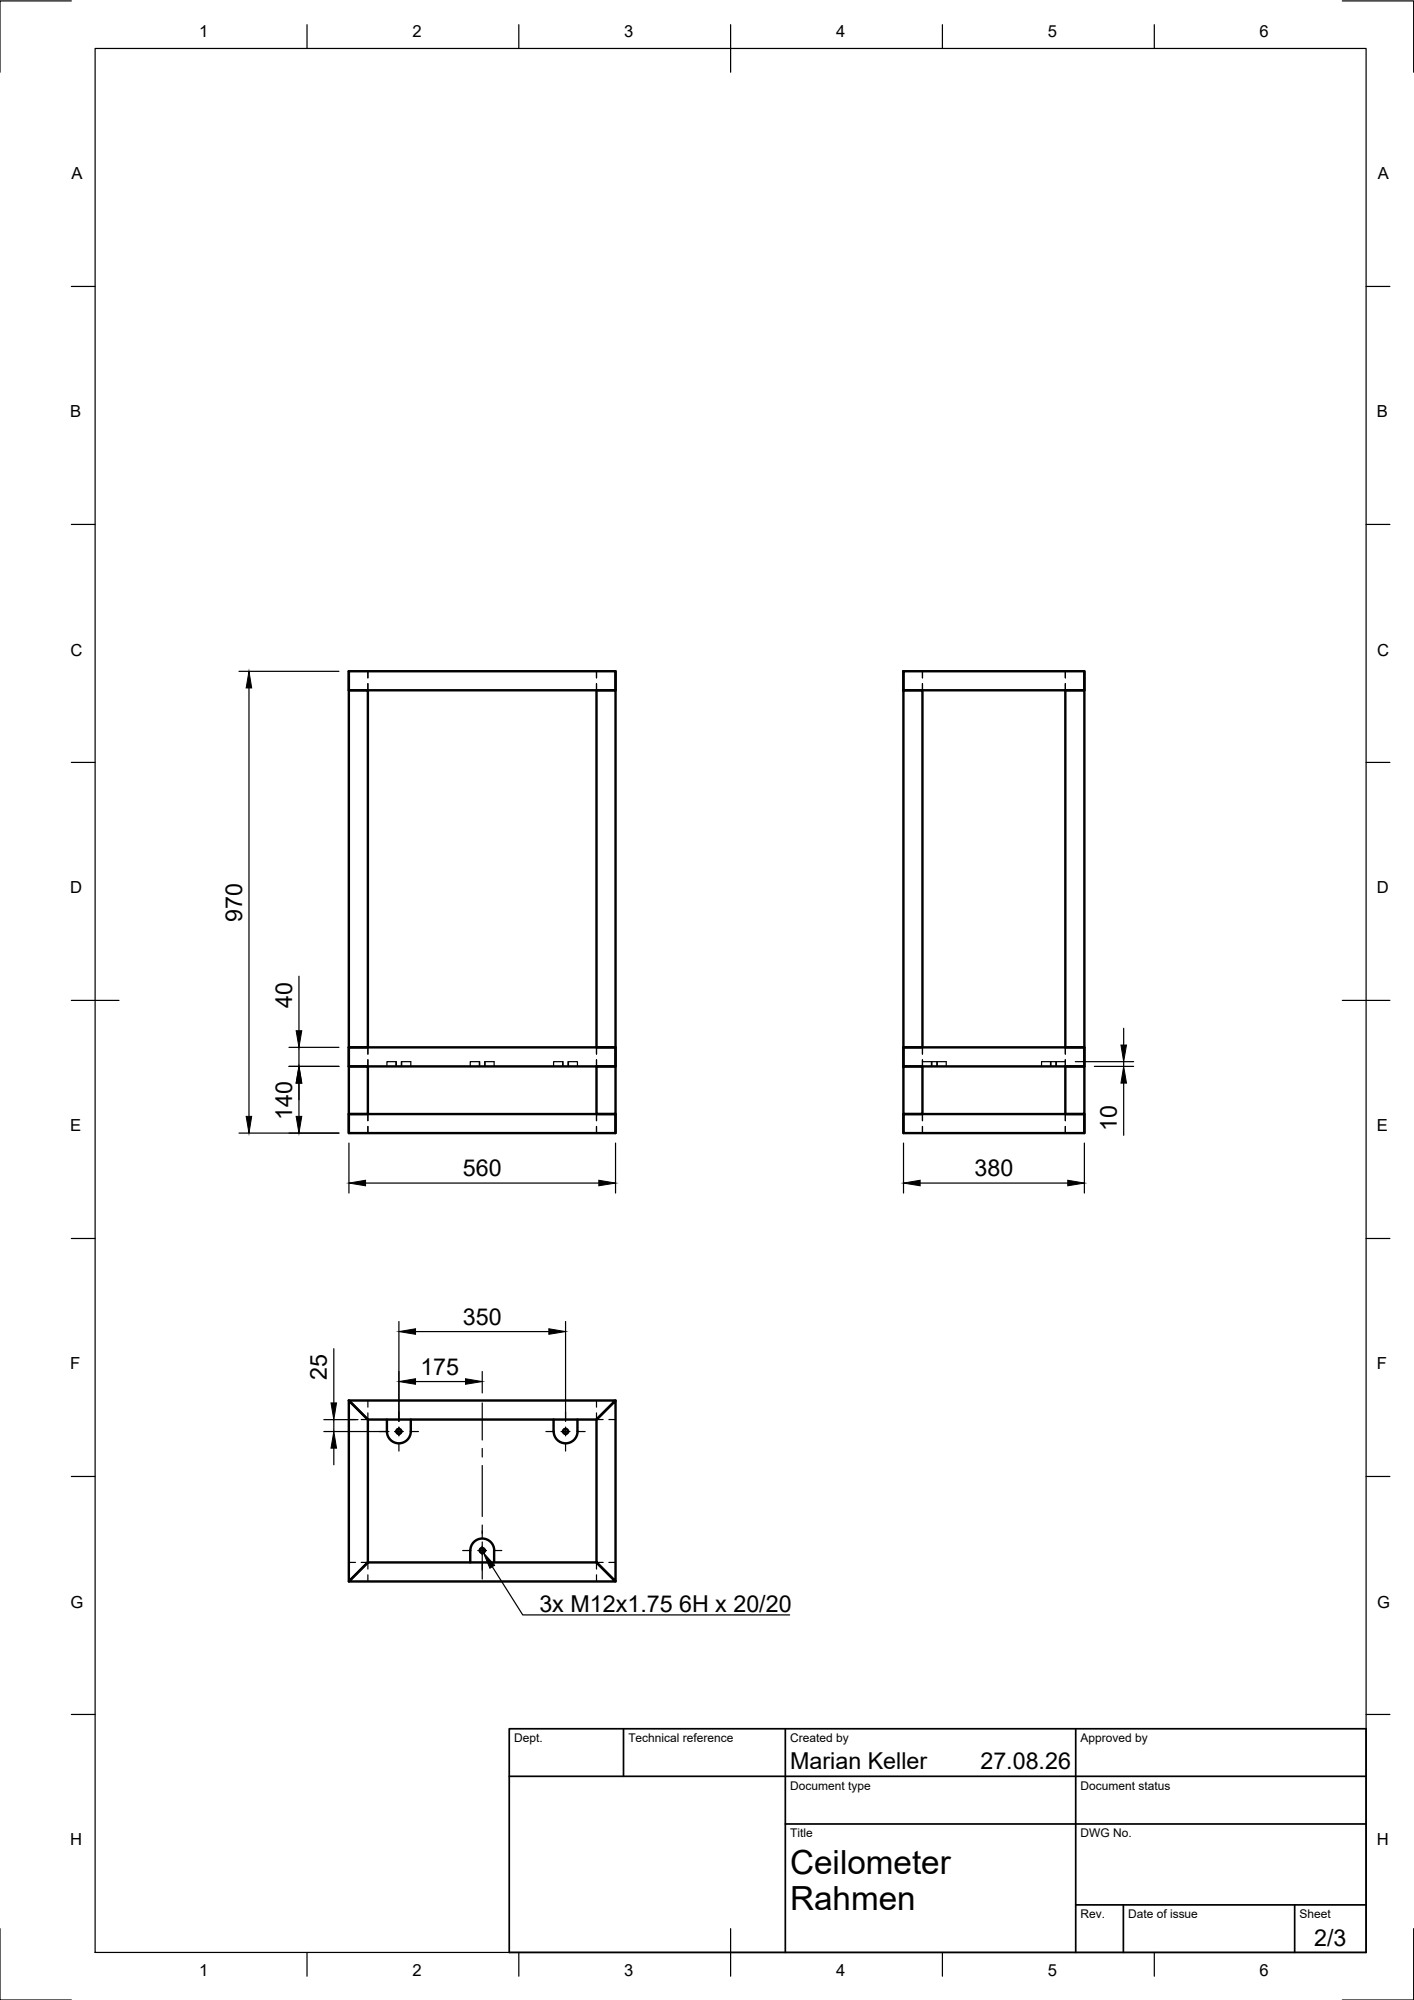
[picture p10: page 2]

Dept. | Technical reference | Created by Marian Keller 27.08.26 | Approved by

Document type | Document status

Rahmen

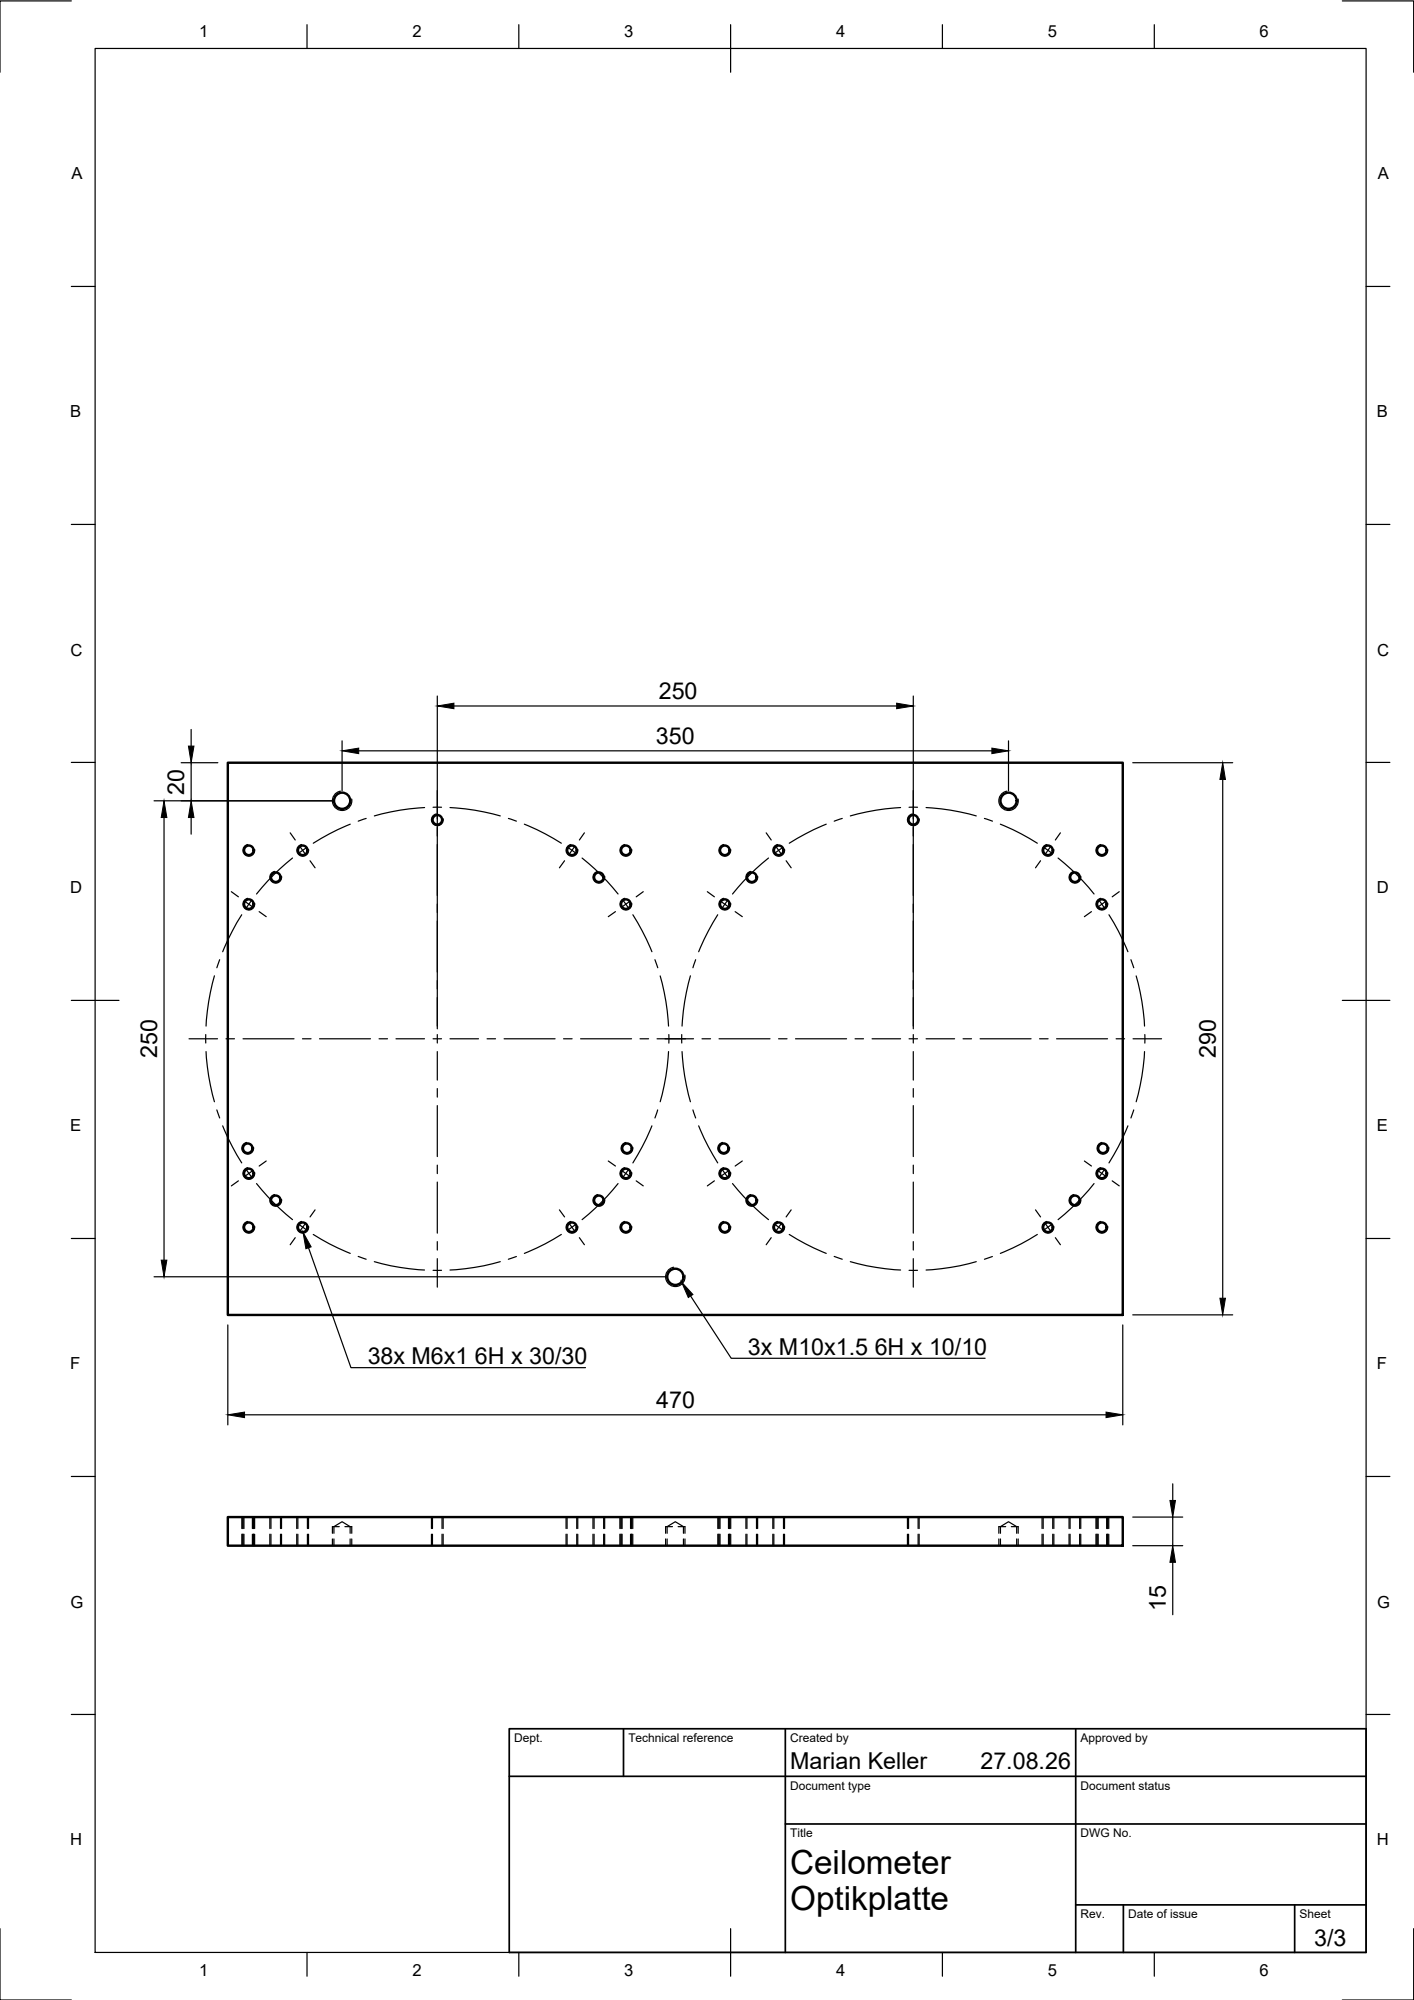
[picture p11: page 3]

Dept. | Technical reference | Created by Marian Keller 27.08.26 | Approved by

Document type | Document status

Optikplatte
