FogCast-Konstanz/ceilometer/hardware/electronics/simulations/LD_CS_Filter.asc

C1: Cap; 10n
C2: Cap; 10n
C3: Cap; 10n
C4: Cap; 10n
C5: Cap; 10n
C6: Cap; 10n
R1: Res; 10k
R2: Res; 10k
R3: Res; 10k
R4: Res; 10k
V1: voltage; 1; AC 1
V2: voltage; 1; AC 1
Named nets: 0
.ac oct 10 1 10Meg
