FogCast-Konstanz/ceilometer/hardware/electronics/simulations/LD_CS_Filter_tr.asc

C1: Cap; 10n
C2: Cap; 10n
C3: Cap; 10n
R1: Res; 10k
R2: Res; 10k
V1: voltage; PULSE(0 100m 0 1n 1n 1/40); AC 1
Named nets: 0
.tran 100m
