FogCast-Konstanz/ceilometer/hardware/electronics/mainboard/Ceilometer-Mainboard.kicad_pcb

## KiCad design hardware/electronics/mainboard/Ceilometer-Mainboard.kicad_pcb (2026-11-01)

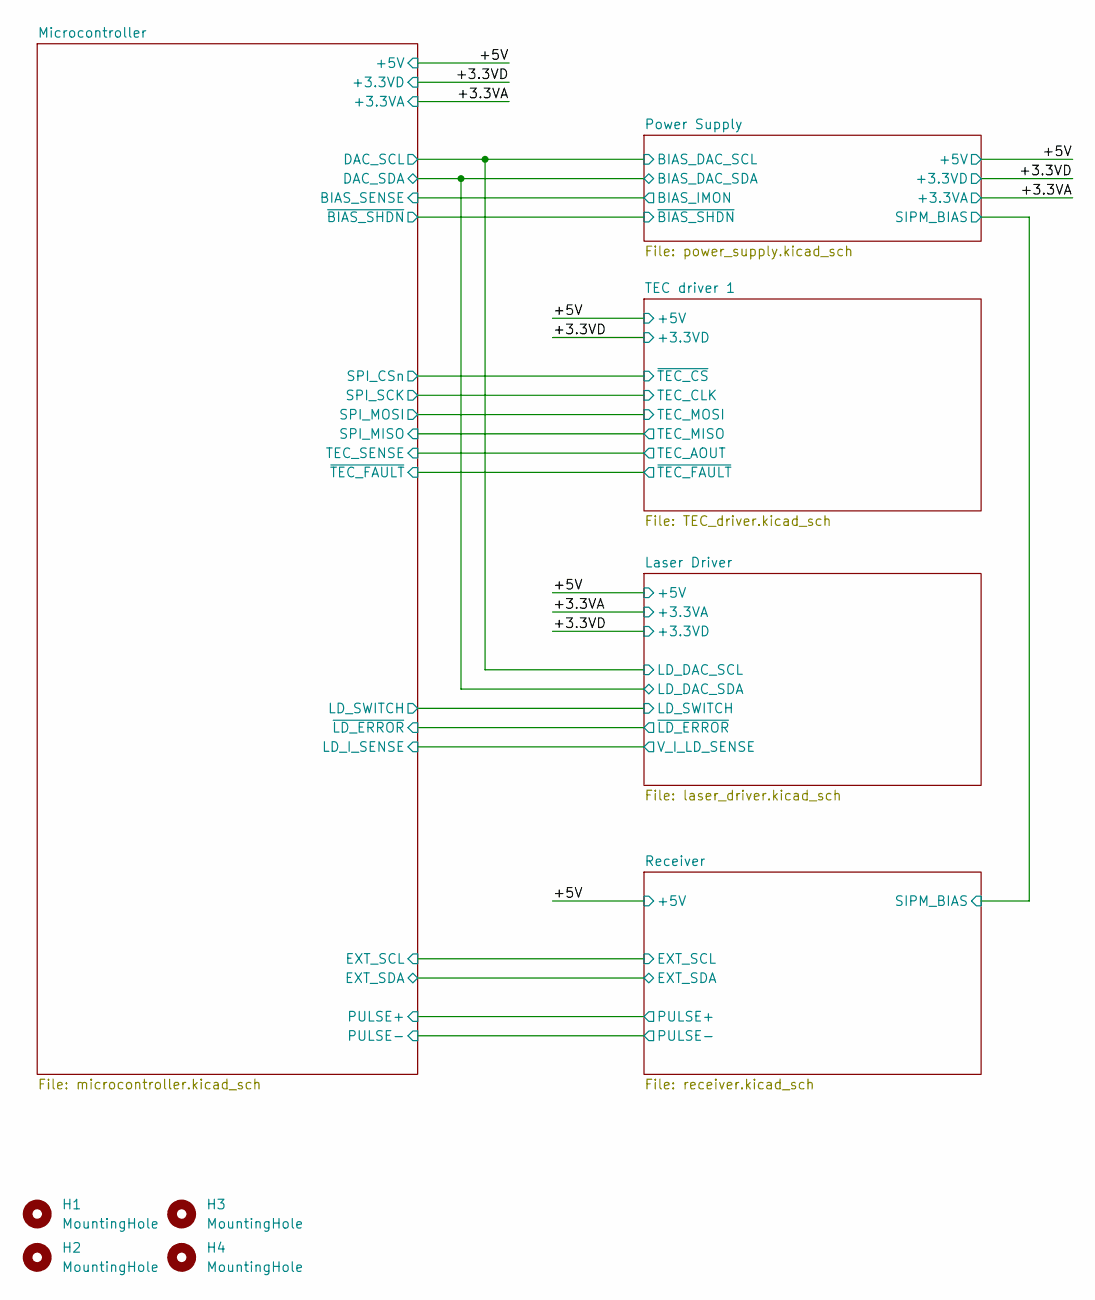
[picture p12: schematic Ceilometer-Mainboard.kicad_sch]

Parts:
H1, H2, H3, H4: MountingHole; MountingHole_2.5mm

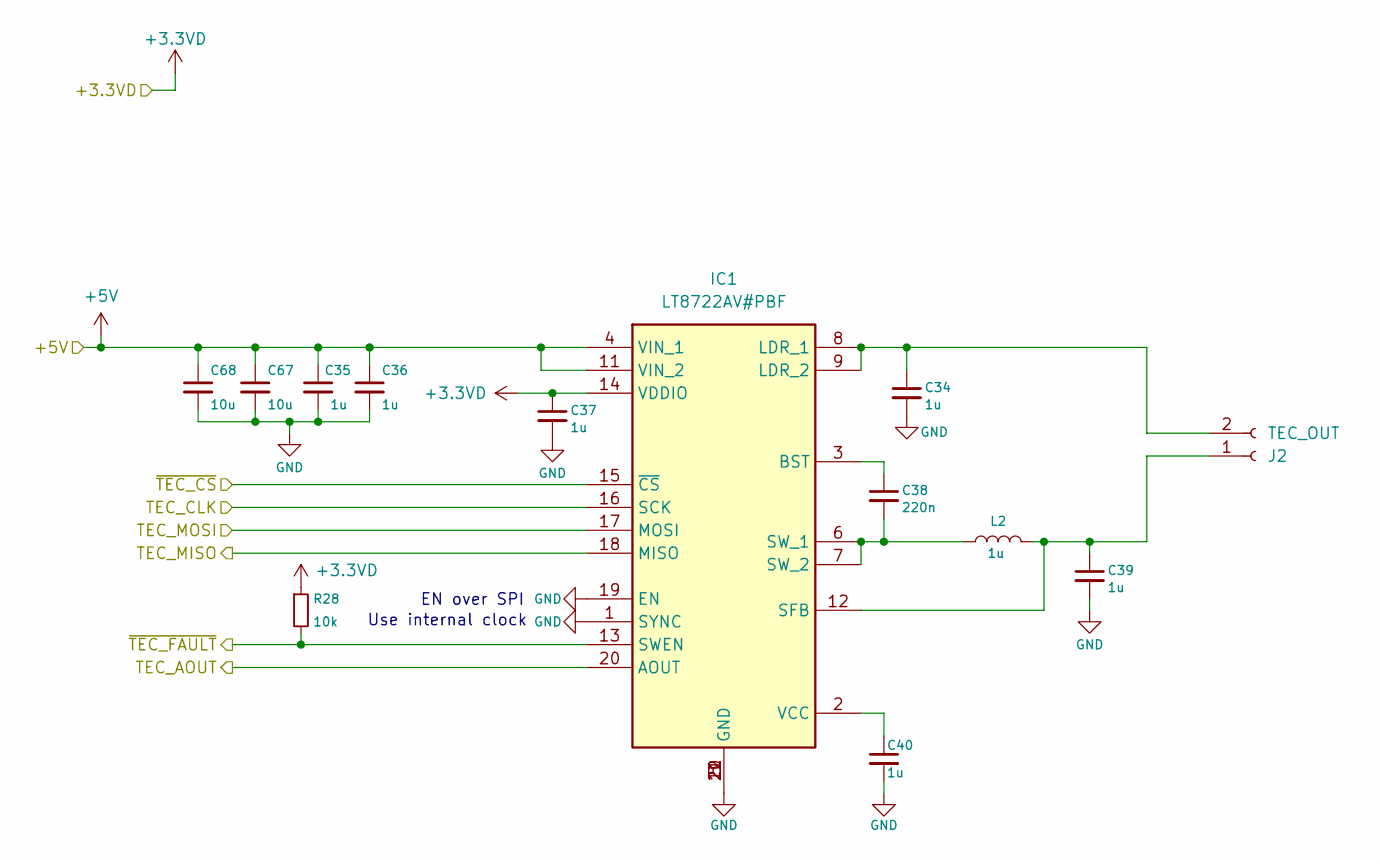
[picture p13: schematic TEC_driver.kicad_sch]

Parts:
C34, C35, C36, C37, C39, C40: 1u; C_0402_1005Metric; Voltage 35V; MPN C1005X5R1V105K050BE
C38: 220n; C_0402_1005Metric; Voltage 63V; MPN GRM155R61J224ME01J
C67, C68: 10u; C_0805_2012Metric; Voltage 50V; PartNumber GRM21BR61H106KE43K
IC1: LT8722AV#PBF; LT8722AVPBF; Mouser Part Number 584-LT8722AVPBF
J2: TEC_OUT; Molex_Pico-EZmate_78171-0002_1x02-1MP_P1.20mm_Vertical
L2: 1u; L_Wurth_WE-PMFI-252012; MPN 74479325207210
R28: 10k; R_0402_1005Metric; MPN ERA-2AEB103X

Connections:
+3.3VD: C37.1, IC1.14 (VDDIO), R28.1; also elsewhere on the board
+5V: C35.1, C36.1, C67.1, C68.1, IC1.4 (VIN_1), IC1.11 (VIN_2); also elsewhere on the board
/Microcontroller/SPI_CSn: IC1.15 (~CS); also elsewhere on the board
/Microcontroller/SPI_MISO: IC1.18 (MISO); also elsewhere on the board
/Microcontroller/SPI_MOSI: IC1.17 (MOSI); also elsewhere on the board
/Microcontroller/SPI_SCK: IC1.16 (SCK); also elsewhere on the board
/Microcontroller/TEC_SENSE: IC1.20 (AOUT); also elsewhere on the board
/Microcontroller/~TEC_FAULT: IC1.13 (SWEN), R28.2; also elsewhere on the board
GND: C34.2, C35.2, C36.2, C37.2, C39.2, C40.2, C67.2, C68.2, IC1.1 (SYNC), IC1.5 (GND), IC1.10 (GND), IC1.19 (EN), IC1.21 (GND), IC1.22 (GND); also elsewhere on the board
unnamed: C38.1, IC1.3 (BST)
unnamed: C34.1, IC1.8 (LDR_1), IC1.9 (LDR_2), J2.2
unnamed: C39.1, IC1.12 (SFB), J2.1, L2.2
unnamed: C38.2, IC1.6 (SW_1), IC1.7 (SW_2), L2.1
unnamed: C40.1, IC1.2 (VCC)

Notes on the sheet:
EN over SPI
Use internal clock

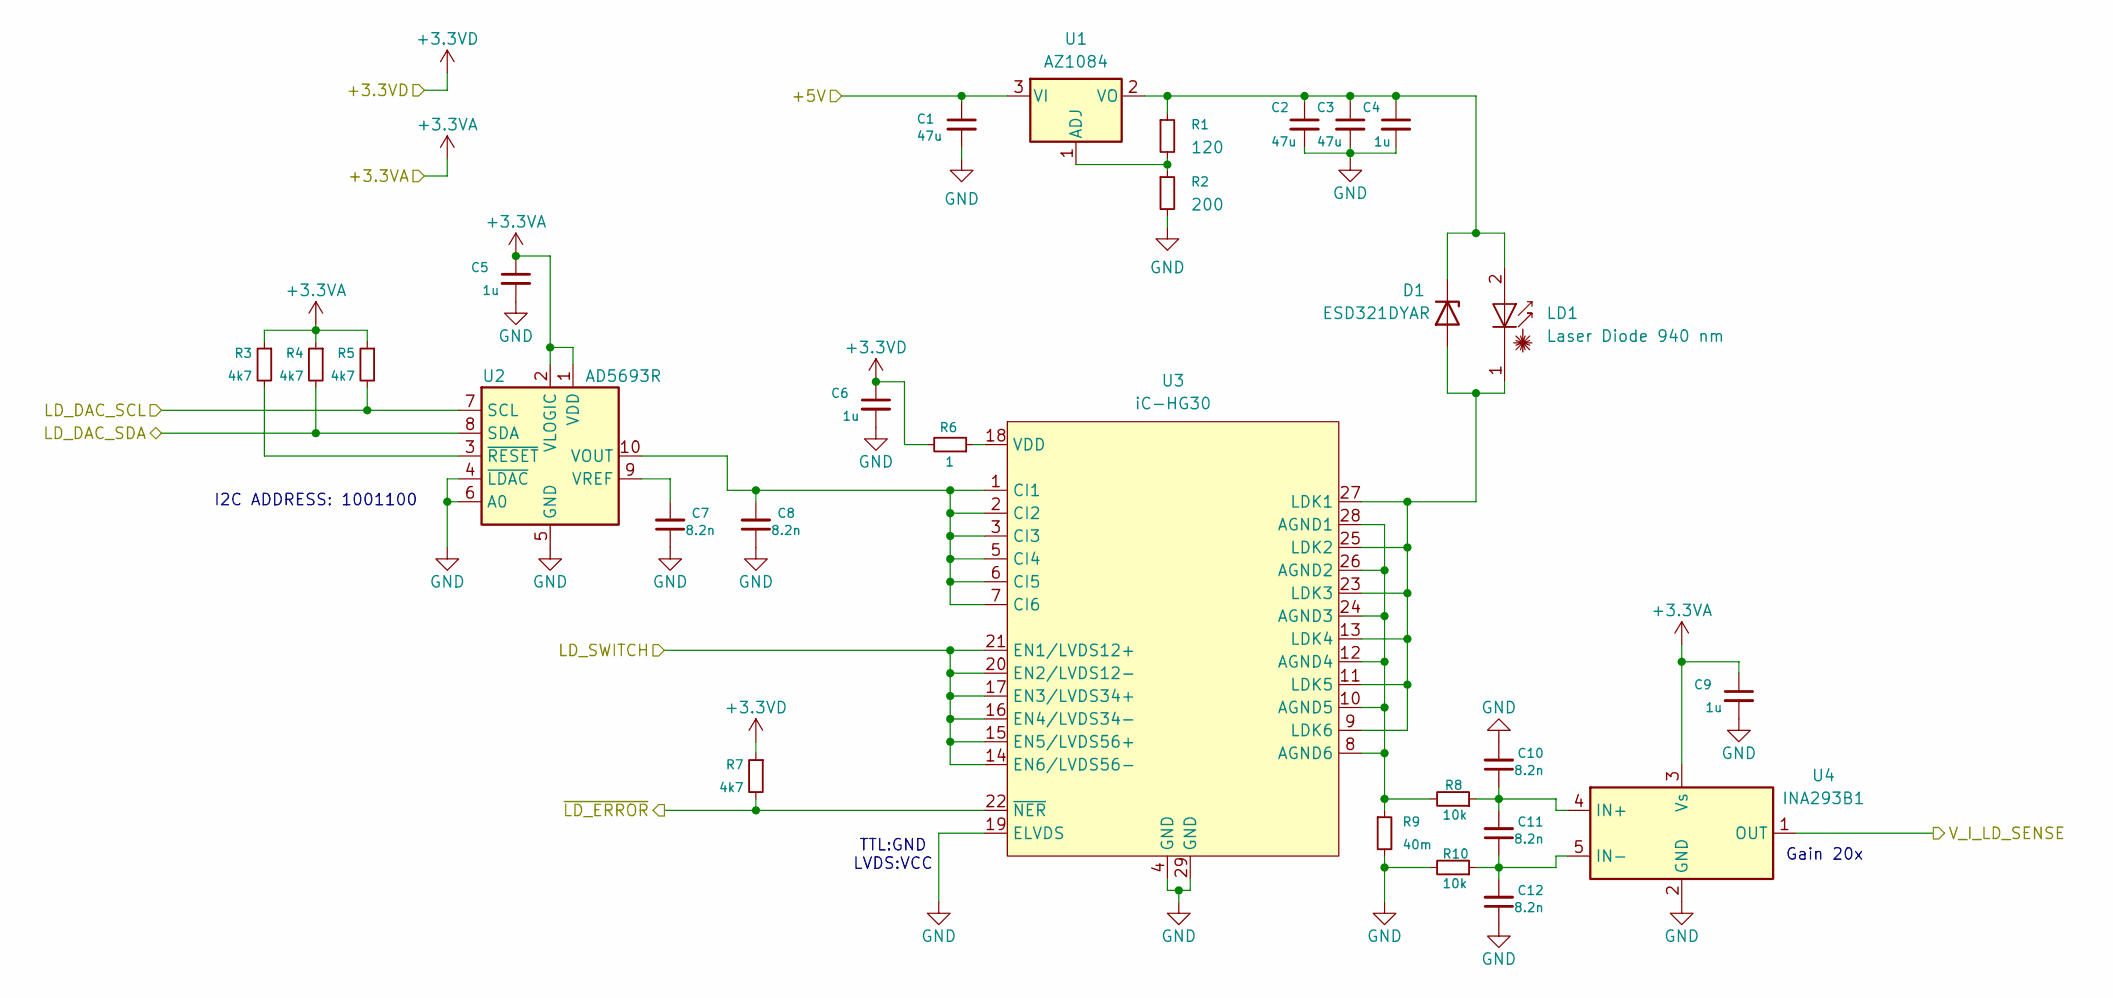
[picture p14: schematic laser_driver.kicad_sch]

Parts:
C1, C2, C3: 47u; C_0805_2012Metric; Voltage 10V; MPN LMK212BBJ476MG-T
C4, C5, C6, C9: 1u; C_0402_1005Metric; Voltage 35V; MPN C1005X5R1V105K050BE
C7, C8, C10, C11, C12: 8.2n; C_0402_1005Metric; Voltage 50V; MPN GRM1555C1H822JE01D
D1: ESD321DYAR; D_SOD-523; MPN ESD321DYAR
LD1: Laser Diode 940 nm; Molex_Pico-EZmate_78171-0002_1x02-1MP_P1.20mm_Vertical; MPN 781710002
R1: 120; R_0402_1005Metric; MPN ERA-2AEB121X
R2: 200; R_0402_1005Metric; MPN ERA-2AED201X
R3, R4, R5, R7: 4k7; R_0402_1005Metric; MPN ERA-2AED472X
R6: 1; R_0402_1005Metric; MPN CRCW04021R00FKED
R8, R10: 10k; R_0402_1005Metric; MPN ERA-2AEB103X
R9: 40m; R_0603_1608Metric; MPN PE0603DRF570R04L
U1: AZ1084; TO-263-2; MPN AZ1084CD-ADJTRG1
U2: AD5693R; MSOP-10_3x3mm_P0.5mm; MPN AD5693RARMZ-RL7
U3: iC-HG30; QFN-28-1EP_5x5mm_P0.5mm_EP3.1x3.15mm_ThermalVias; MPN iC-HG30
U4: INA293B1; SOT-23-5; MPN INA293B1IDBVR

Connections:
+3.3VA: C5.1, C9.1, R3.1, R4.1, R5.1, U2.1 (VDD), U2.2 (VLOGIC), U4.3 (Vs); also elsewhere on the board
+3.3VD: C6.1, R6.2, R7.1; also elsewhere on the board
+5V: C1.1, U1.3 (VI); also elsewhere on the board
/Laser Driver/LD_DAC_SCL: R5.2, U2.7 (SCL); also elsewhere on the board
/Laser Driver/LD_DAC_SDA: R4.2, U2.8 (SDA); also elsewhere on the board
/Laser Driver/LD_SWITCH: U3.14 (EN6/LVDS56-), U3.15 (EN5/LVDS56+), U3.16 (EN4/LVDS34-), U3.17 (EN3/LVDS34+), U3.20 (EN2/LVDS12-), U3.21 (EN1/LVDS12+); also elsewhere on the board
/Laser Driver/V_I_LD_SENSE: U4.1 (OUT); also elsewhere on the board
/Laser Driver/~LD_ERROR: R7.2, U3.22 (~NER); also elsewhere on the board
GND: C1.2, C2.2, C3.2, C4.2, C5.2, C6.2, C7.1, C8.1, C9.2, C10.2, C12.1, R2.2, R9.2, R10.2, U2.4 (~LDAC), U2.5 (GND), U2.6 (A0), U3.4 (GND), U3.19 (ELVDS), U3.29 (GND), U4.2 (GND); also elsewhere on the board
unnamed: D1.2 (A), LD1.1 (K), U3.9 (LDK6), U3.11 (LDK5), U3.13 (LDK4), U3.23 (LDK3), U3.25 (LDK2), U3.27 (LDK1)
unnamed: C2.1, C3.1, C4.1, D1.1 (K), LD1.2 (A), R1.1, U1.2 (VO)
unnamed: R1.2, R2.1, U1.1 (ADJ)
unnamed: C8.2, U2.10 (VOUT), U3.1 (CI1), U3.2 (CI2), U3.3 (CI3), U3.5 (CI4), U3.6 (CI5), U3.7 (CI6)
unnamed: C7.2, U2.9 (VREF)
unnamed: R3.2, U2.3 (~RESET)
unnamed: R8.2, R9.1, U3.8 (AGND6), U3.10 (AGND5), U3.12 (AGND4), U3.24 (AGND3), U3.26 (AGND2), U3.28 (AGND1)
unnamed: R6.1, U3.18 (VDD)
unnamed: C10.1, C11.2, R8.1, U4.4 (IN+)
unnamed: C11.1, C12.2, R10.1, U4.5 (IN-)

Notes on the sheet:
I2C ADDRESS: 1001100
TTL:GND LVDS:VCC
Gain 20x

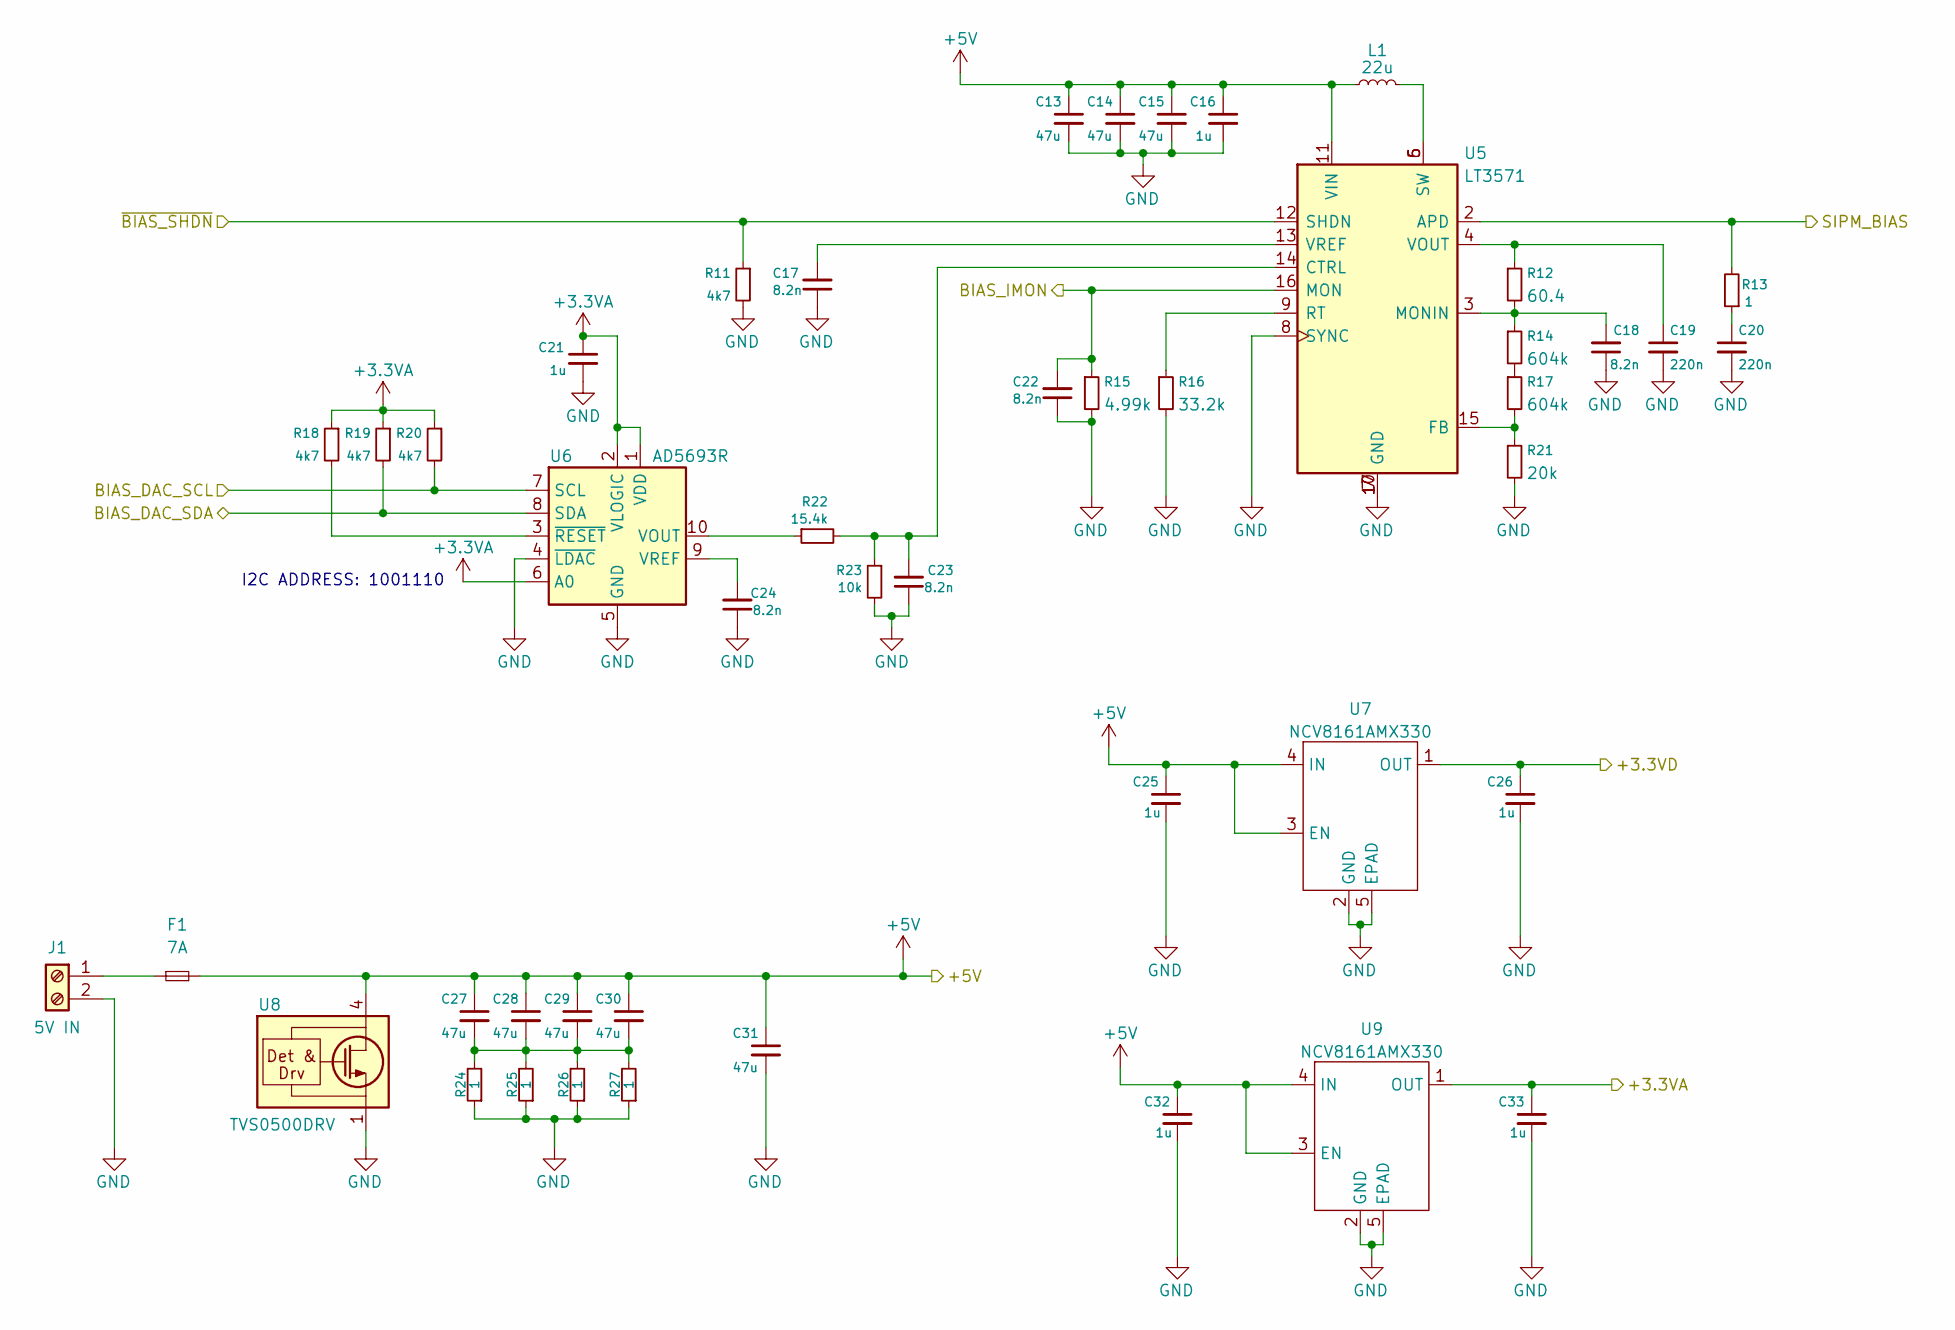
[picture p15: schematic power_supply.kicad_sch]

Parts:
C13, C14, C15, C27, C28, C29, C30, C31: 47u; C_0805_2012Metric; Voltage 10V; MPN LMK212BBJ476MG-T
C16, C21, C25, C26, C32, C33: 1u; C_0402_1005Metric; Voltage 35V; MPN C1005X5R1V105K050BE
C17, C18, C22, C23, C24: 8.2n; C_0402_1005Metric; Voltage 50V; MPN GRM1555C1H822JE01D
C19, C20: 220n; C_0402_1005Metric; Voltage 63V; MPN GRM155R61J224ME01J
F1: 7A; Fuseholder_Littelfuse_Nano2_154x; MPN 0154007.DRT
J1: 5V IN; TerminalBlock_RND_205-00001_1x02_P5.00mm_Horizontal
L1: 22u; L_Abracon_ASPI-4030S; MPN ASPI-4030S-220M-T
R11, R18, R19, R20: 4k7; R_0402_1005Metric; MPN ERA-2AED472X
R12: 60.4; R_0402_1005Metric; MPN RG1005P-60R4-D-T10
R13, R24, R25, R26, R27: 1; R_0402_1005Metric; MPN CRCW04021R00FKED
R14, R17: 604k; R_0402_1005Metric; MPN CR0402-FX-6043GLF
R15: 4.99k; R_0402_1005Metric; MPN RT0402BRD074K99L
R16: 33.2k; R_0402_1005Metric; MPN RT0402BRD0733K2L
R21: 20k; R_0402_1005Metric; MPN ERA-2AED203X
R22: 15.4k; R_0402_1005Metric; Tolerance 0.1; MPN RT0402BRD0715K4L
R23: 10k; R_0402_1005Metric; MPN ERA-2AEB103X
U5: LT3571; QFN-16-1EP_3x3mm_P0.5mm_EP1.45x1.45mm_ThermalVias; MPN LT3571EUD#PBF
U6: AD5693R; MSOP-10_3x3mm_P0.5mm; MPN AD5693RARMZ-RL7
U7, U9: NCV8161AMX330; Texas_XDFN-4_1x1mm_P0.65mm; MPN NCV8161AMX330TBG
U8: TVS0500DRV; WSON-6-1EP_2x2mm_P0.65mm_EP1x1.6mm; MPN TVS0500DRV

Connections:
+3.3VA: C21.1, C33.1, R18.1, R19.1, R20.1, U6.1 (VDD), U6.2 (VLOGIC), U6.6 (A0), U9.1 (OUT); also elsewhere on the board
+3.3VD: C26.1, U7.1 (OUT); also elsewhere on the board
+5V: C13.1, C14.1, C15.1, C16.1, C25.1, C27.1, C28.1, C29.1, C30.1, C31.1, C32.1, F1.2, L1.1, U5.11 (VIN), U7.3 (EN), U7.4 (IN), U8.4 (IN), U8.5 (IN), U8.6 (IN), U9.3 (EN), U9.4 (IN); also elsewhere on the board
/Laser Driver/LD_DAC_SCL: R20.2, U6.7 (SCL); also elsewhere on the board
/Laser Driver/LD_DAC_SDA: R19.2, U6.8 (SDA); also elsewhere on the board
/Microcontroller/BIAS_SENSE: C22.2, R15.1, U5.16 (MON); also elsewhere on the board
/Microcontroller/~BIAS_SHDN: R11.1, U5.12 (SHDN); also elsewhere on the board
/Power Supply/SIPM_BIAS: R13.2, U5.2 (APD); also elsewhere on the board
GND: C13.2, C14.2, C15.2, C16.2, C17.1, C18.1, C19.2, C20.2, C21.2, C22.1, C23.1, C24.1, C25.2, C26.2, C31.2, C32.2, C33.2, J1.2, R11.2, R15.2, R16.2, R21.2, R23.2, R24.1, R25.1, R26.1, R27.1, U5.7 (GND), U5.8 (SYNC), U5.10 (GND), U5.17 (GND), U6.4 (~LDAC), U6.5 (GND), U7.2 (GND), U7.5 (EPAD), U8.1 (GND), U8.2 (GND), U8.3 (GND), U8.7 (GND), U9.2 (GND), U9.5 (EPAD); also elsewhere on the board
unnamed: C20.1, R13.1
unnamed: C27.2, C28.2, C29.2, C30.2, R24.2, R25.2, R26.2, R27.2
unnamed: F1.1, J1.1
unnamed: L1.2, U5.5 (SW), U5.6 (SW)
unnamed: R14.2, R17.1
unnamed: C23.2, R22.2, R23.1, U5.14 (CTRL)
unnamed: R17.2, R21.1, U5.15 (FB)
unnamed: C18.2, R12.2, R14.1, U5.3 (MONIN)
unnamed: R16.1, U5.9 (RT)
unnamed: C19.1, R12.1, U5.4 (VOUT)
unnamed: C17.2, U5.13 (VREF)
unnamed: R22.1, U6.10 (VOUT)
unnamed: C24.2, U6.9 (VREF)
unnamed: R18.2, U6.3 (~RESET)

Notes on the sheet:
I2C ADDRESS: 1001110

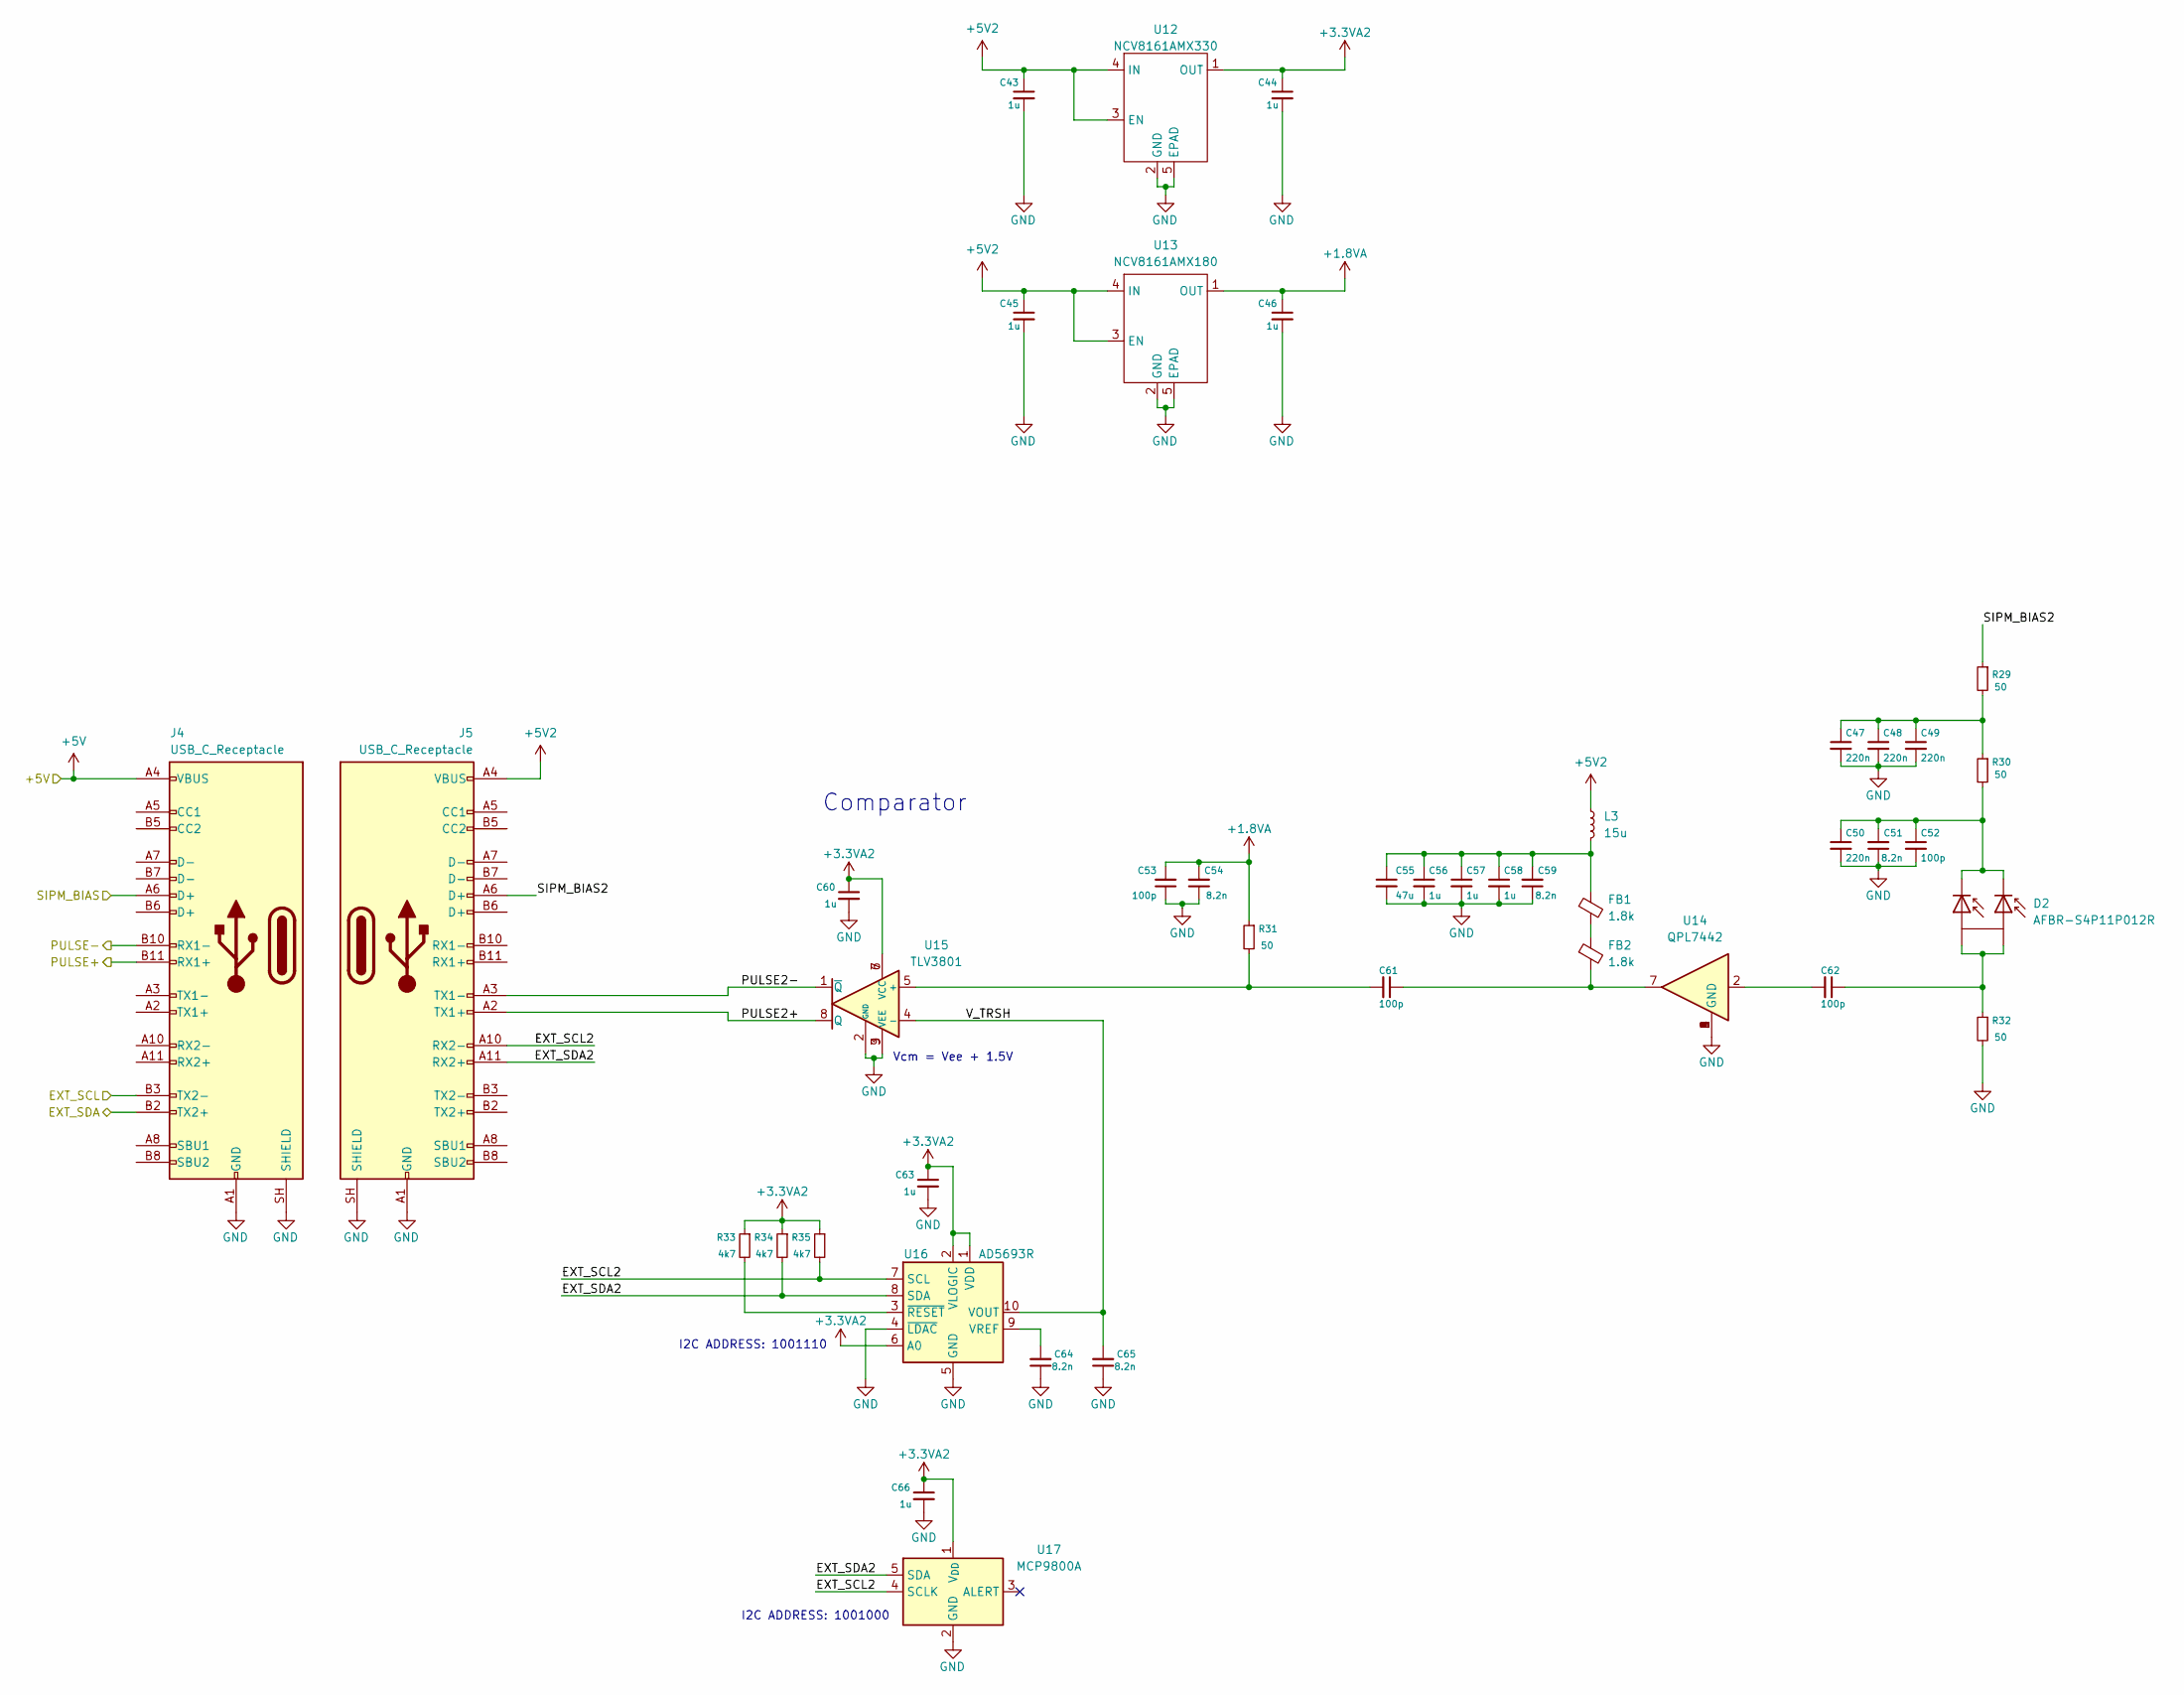
[picture p16: schematic receiver.kicad_sch]

Parts:
C43, C44, C45, C46, C56, C57, C58, C60, C63, C66: 1u; C_0402_1005Metric; Voltage 35V; MPN C1005X5R1V105K050BE
C47, C48, C49, C50: 220n; C_0402_1005Metric; Voltage 63V; MPN GRM155R61J224ME01J
C51, C54, C59, C64, C65: 8.2n; C_0402_1005Metric; Voltage 50V; MPN GRM1555C1H822JE01D
C52, C53: 100p; C_0402_1005Metric; Voltage 50V; MPN RF15N101J500CT
C55: 47u; C_0805_2012Metric; Voltage 10V; MPN LMK212BBJ476MG-T
C61, C62: 100p; C_0201_0603Metric; Voltage 25V; MPN CC0201JPNPO8BN101
D2: AFBR-S4P11P012R; Broadcom_AFBR-S4P11P012R; MPN AFBR-S4P11P012R
FB1, FB2: 1.8k; L_0402_1005Metric; MPN MMZ1005A182ET000
J4, J5: USB_C_Receptacle; USB_C_Receptacle_Amphenol_12401610E4-2A; MPN 12401610E4#2A
L3: 15u; PFL4514; MPN PFL4514-153MEC
R29, R30: 50; R_0402_1005Metric; MPN TNPW040250R0BEED
R31, R32: 50; R_0201_0603Metric; MPN TNPW020150R0DEED
R33, R34, R35: 4k7; R_0402_1005Metric; MPN ERA-2AED472X
U12: NCV8161AMX330; Texas_XDFN-4_1x1mm_P0.65mm; MPN NCV8161AMX330TBG
U13: NCV8161AMX180; Texas_XDFN-4_1x1mm_P0.65mm; MPN NCV8161AMX330TBG
U14: QPL7442; DFN-8-1EP_2x2mm_P0.5mm_EP0.8x1.6mm; MPN QPL7442
U15: TLV3801; TLV3801DSGR; MPN TLV3801DSGR
U16: AD5693R; MSOP-10_3x3mm_P0.5mm; MPN AD5693RARMZ-RL7
U17: MCP9800A; SOT-23-5; MPN MCP9800A0T-M/OT

Connections:
+1.8VA: C46.1, C53.2, C54.2, R31.1, U13.1 (OUT)
+3.3VA2: C44.1, C60.1, C63.1, C66.1, R33.1, R34.1, R35.1, U12.1 (OUT), U15.6 (VCC), U15.7 (VCC), U16.1 (VDD), U16.2 (VLOGIC), U16.6 (A0), U17.1 (V_{DD})
+5V: J4.A4 (VBUS), J4.A9 (VBUS), J4.B4 (VBUS), J4.B9 (VBUS); also elsewhere on the board
+5V2: C43.1, C45.1, J5.A4 (VBUS), J5.A9 (VBUS), J5.B4 (VBUS), J5.B9 (VBUS), L3.1, U12.3 (EN), U12.4 (IN), U13.3 (EN), U13.4 (IN)
/Microcontroller/EXT_SCL: J4.B3 (TX2-); also elsewhere on the board
/Microcontroller/EXT_SDA: J4.B2 (TX2+); also elsewhere on the board
/Microcontroller/PULSE+: J4.B11 (RX1+); also elsewhere on the board
/Microcontroller/PULSE-: J4.B10 (RX1-); also elsewhere on the board
/Power Supply/SIPM_BIAS: J4.A6 (D+); also elsewhere on the board
/Receiver/EXT_SCL2: J5.A10 (RX2-), R35.2, U16.7 (SCL), U17.4 (SCLK)
/Receiver/EXT_SDA2: J5.A11 (RX2+), R34.2, U16.8 (SDA), U17.5 (SDA)
/Receiver/PULSE2+: J5.A2 (TX1+), U15.8 (Q)
/Receiver/PULSE2-: J5.A3 (TX1-), U15.1 (~Q)
/Receiver/SIPM_BIAS2: J5.A6 (D+), R29.1
/Receiver/V_TRSH: C65.2, U15.4 (-), U16.10 (VOUT)
GND: C43.2, C44.2, C45.2, C46.2, C47.2, C48.2, C49.2, C50.2, C51.1, C52.2, C53.1, C54.1, C55.2, C56.2, C57.2, C58.2, C59.1, C60.2, C63.2, C64.1, C65.1, C66.2, J4.A1 (GND), J4.A12 (GND), J4.B1 (GND), J4.B12 (GND), J4.SH (SHIELD), J5.A1 (GND), J5.A12 (GND), J5.B1 (GND), J5.B12 (GND), J5.SH (SHIELD), R32.2, U12.2 (GND), U12.5 (EPAD), U13.2 (GND), U13.5 (EPAD), U14.1 (GND), U14.3 (GND), U14.4 (GND), U14.6 (GND), U14.8 (GND), U14.9 (GND), U15.2 (GND), U15.3 (VEE), U15.9 (VEE), U15.13 (VEE), U16.4 (~LDAC), U16.5 (GND), U17.2 (GND); also elsewhere on the board
unnamed: C47.1, C48.1, C49.1, R29.2, R30.1
unnamed: C50.1, C51.2, C52.1, D2.1 (K), D2.2 (K), R30.2
unnamed: C55.1, C56.1, C57.1, C58.1, C59.2, FB1.1, L3.2
unnamed: C61.1, FB2.2, U14.7
unnamed: C62.1, D2.3 (A), D2.4 (A), R32.1
unnamed: C62.2, U14.2
unnamed: FB1.2, FB2.1
unnamed: C61.2, R31.2, U15.5 (+)
unnamed: C64.2, U16.9 (VREF)
unnamed: R33.2, U16.3 (~RESET)

Notes on the sheet:
Vcm = Vee + 1.5V
I2C ADDRESS: 1001000
I2C ADDRESS: 1001110
Comparator

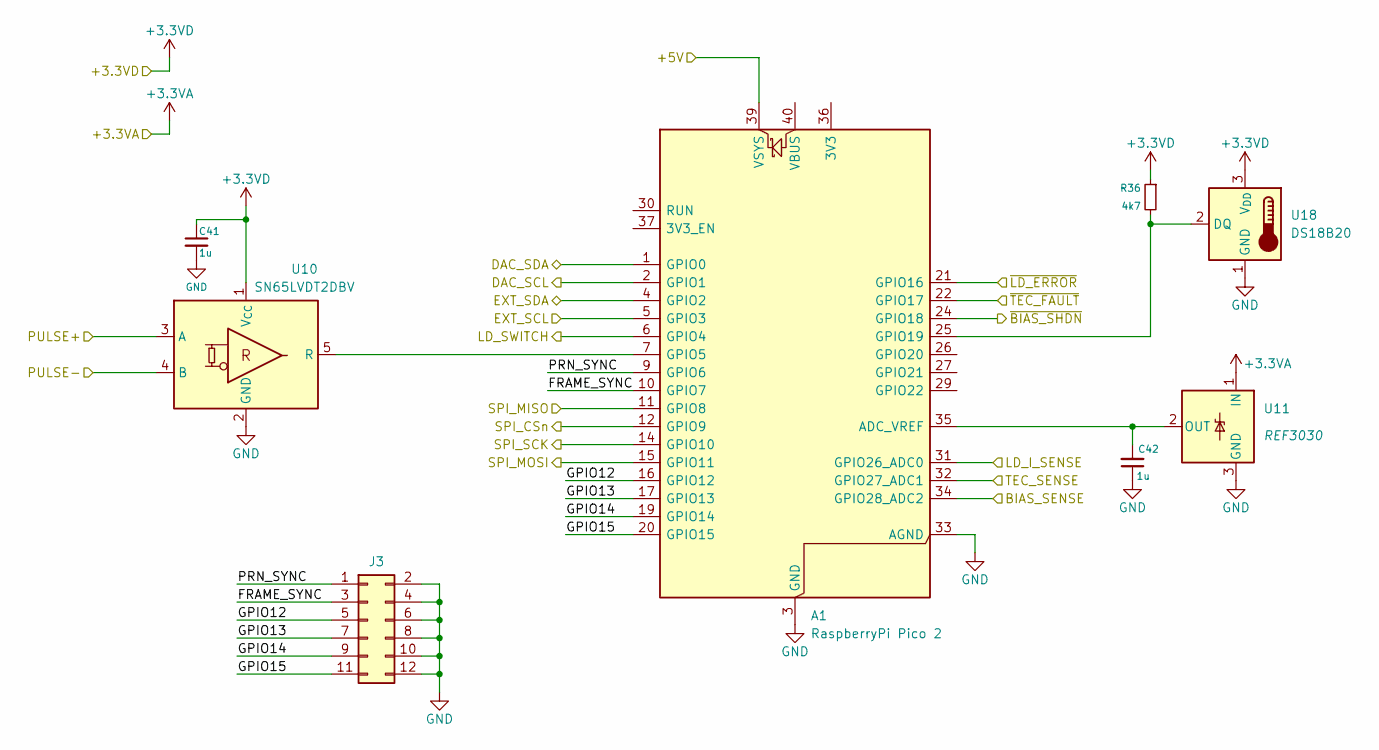
[picture p17: schematic microcontroller.kicad_sch]

Parts:
A1: RaspberryPi Pico 2; RaspberryPi_Pico_Common_SMD; MPN RP2350-Plus
C41, C42: 1u; C_0402_1005Metric; Voltage 35V; MPN C1005X5R1V105K050BE
J3: Conn_02x06_Odd_Even; PinHeader_2x06_P2.54mm_Vertical
R36: 4k7; R_0402_1005Metric; MPN ERA-2AED472X
U10: SN65LVDT2DBV; SOT-23-5; MPN SN65LVDT2DBV
U11: REF3030; SOT-23; MPN REF3030AIDBZT
U18: DS18B20; PinHeader_1x03_P2.54mm_Vertical; MPN DS18B20

Connections:
+3.3VA: U11.1 (IN); also elsewhere on the board
+3.3VD: C41.1, R36.1, U10.1 (V_{CC}), U18.3 (V_{DD}); also elsewhere on the board
+5V: A1.39 (VSYS); also elsewhere on the board
/Laser Driver/LD_DAC_SCL: A1.2 (GPIO1); also elsewhere on the board
/Laser Driver/LD_DAC_SDA: A1.1 (GPIO0); also elsewhere on the board
/Laser Driver/LD_SWITCH: A1.6 (GPIO4); also elsewhere on the board
/Laser Driver/V_I_LD_SENSE: A1.31 (GPIO26_ADC0); also elsewhere on the board
/Laser Driver/~LD_ERROR: A1.21 (GPIO16); also elsewhere on the board
/Microcontroller/BIAS_SENSE: A1.34 (GPIO28_ADC2); also elsewhere on the board
/Microcontroller/EXT_SCL: A1.5 (GPIO3); also elsewhere on the board
/Microcontroller/EXT_SDA: A1.4 (GPIO2); also elsewhere on the board
/Microcontroller/FRAME_SYNC: A1.10 (GPIO7), J3.3
/Microcontroller/GPIO12: A1.16 (GPIO12), J3.5
/Microcontroller/GPIO13: A1.17 (GPIO13), J3.7
/Microcontroller/GPIO14: A1.19 (GPIO14), J3.9
/Microcontroller/GPIO15: A1.20 (GPIO15), J3.11
/Microcontroller/PRN_SYNC: A1.9 (GPIO6), J3.1
/Microcontroller/PULSE+: U10.3 (A); also elsewhere on the board
/Microcontroller/PULSE-: U10.4 (B); also elsewhere on the board
/Microcontroller/SPI_CSn: A1.12 (GPIO9); also elsewhere on the board
/Microcontroller/SPI_MISO: A1.11 (GPIO8); also elsewhere on the board
/Microcontroller/SPI_MOSI: A1.15 (GPIO11); also elsewhere on the board
/Microcontroller/SPI_SCK: A1.14 (GPIO10); also elsewhere on the board
/Microcontroller/TEC_SENSE: A1.32 (GPIO27_ADC1); also elsewhere on the board
/Microcontroller/~BIAS_SHDN: A1.24 (GPIO18); also elsewhere on the board
/Microcontroller/~TEC_FAULT: A1.22 (GPIO17); also elsewhere on the board
GND: A1.3 (GND), A1.8 (GND), A1.13 (GND), A1.18 (GND), A1.23 (GND), A1.28 (GND), A1.33 (AGND), A1.38 (GND), C41.2, C42.1, J3.2, J3.4, J3.6, J3.8, J3.10, J3.12, U10.2 (GND), U11.3 (GND), U18.1 (GND); also elsewhere on the board
unnamed: A1.35 (ADC_VREF), C42.2, U11.2 (OUT)
unnamed: A1.7 (GPIO5), U10.5 (R)
unnamed: A1.25 (GPIO19), R36.2, U18.2 (DQ)

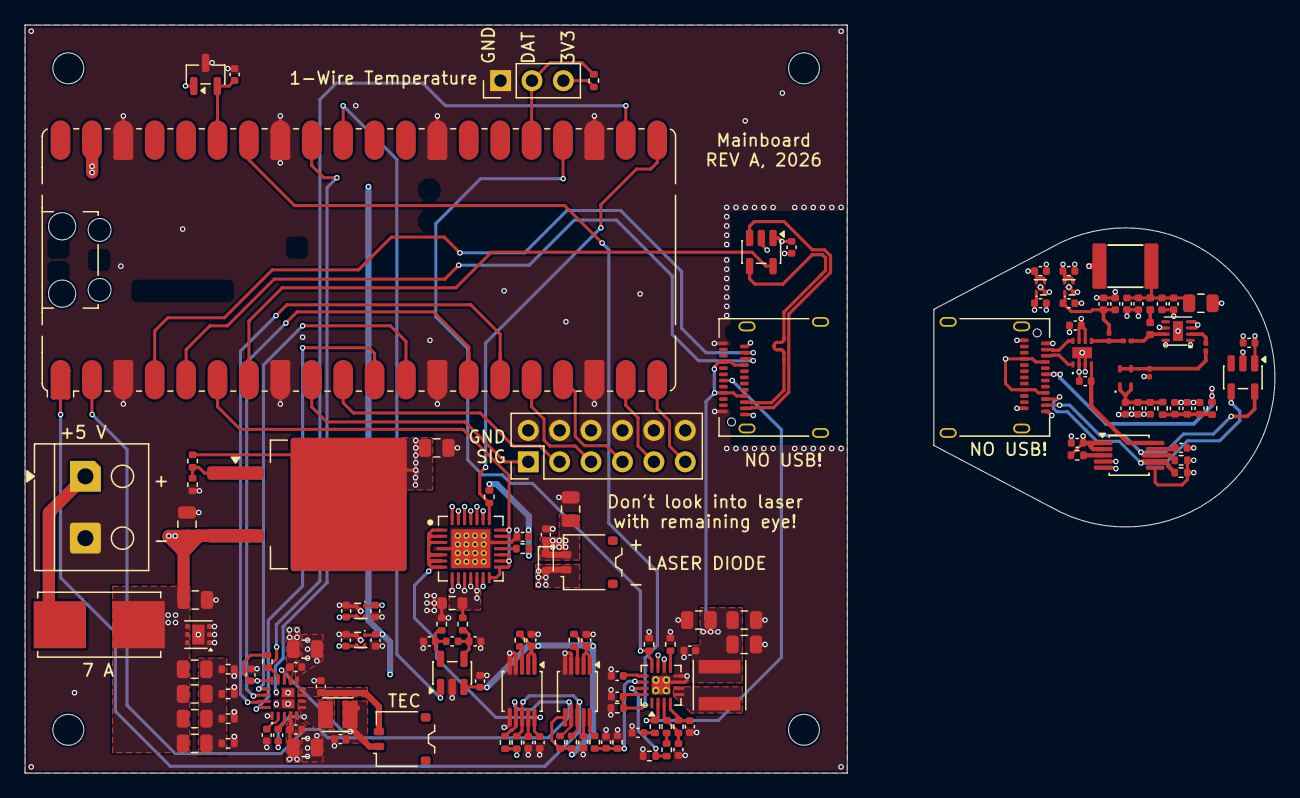
[picture p18: board Ceilometer-Mainboard.kicad_pcb from above]

Board: 4 copper layers, 101.1 x 60.5 mm, 144 parts (0 on the bottom side), 79 nets.

Other parts of the board:
B1, B2: Board
