FogCast-Konstanz/ceilometer/firmware/pico2/include/sequence.h

#pragma once
#include "config.h"
void prn_generate(uint8_t code[PRN_LENGTH]);
void prn_pack(const uint8_t code[PRN_LENGTH], uint32_t words[TX_WORDS]);

void prn_generate_seed(uint8_t code[PRN_LENGTH],uint16_t seed);
