FogCast-Konstanz/ceilometer/(commit log)

2026-10-25 Implement Pico 2 ceilometer peripheral validation firmware
2026-10-25 Add DS18B20 TEC PID and 10-30 C laser interlocks
2026-10-25 Control SiPM overvoltage from receiver temperature with a 50 V target ceiling
2026-10-25 Add USB CDC web console for board bring-up and diagnostics
2026-10-25 Add receiver I2C diagnostics and document USB cable incompatibility
    [board.c, board.h, interlock_tests.c, main.c, stdlib.h, telemetry_tests.c]
2026-11-01 Preserve commissioned firmware and Pi software before monorepo migration
    [bias-off-idle-repeat.csv, bias-series-1809p4.csv, dark-overvoltage-sweep.csv, high-threshold-dark-sweep.csv]
2026-11-01 Organize ceilometer firmware, instrument software and hardware as a monorepo
    [Ceilometer-Mainboard-A.kicad_pcb, Ceilometer-Mainboard-B.kicad_pcb, Ceilometer-Mainboard-B.step, Ceilometer-Mainboard-B2-Edge_Cuts.dxf, Ceilometer-Mainboard.csv, Ceilometer-Mainboard.kicad_pcb, Ceilometer-Mainboard.kicad_sch, Ceilometer-Optikplatte.dxf]
2026-11-01 Pin deployment builds to verified Arm GNU 15.2 toolchain
